ElectronicCats/Minino/docs/esp-sdr-integration.md

# Native SDR Integration in Minino

> **Usage guide:** [`sdr-guia.md`](./sdr-guia.md) (getting started, the
> three ways to use it).
> **Test report:** [`sdr-resultados.md`](./sdr-resultados.md)
> (both boards, both applications, spectrum profiles).
> **Wire protocol, byte by byte:** [`sdr-protocolo.md`](./sdr-protocolo.md)
> (both packet formats, raw bytes, and where each field appears).

Reference document for the integration between Minino (ESP-IDF) and the
software-defined radio firmware. Dual boot has been retired:
the SDR runs **in-process** inside Minino OS, without touching `ota_1`.

- **Date:** 2026-10-19 (updated 2026-10-21)
- **Boards used:** ESP32-C6 rev v0.1 (`f0:f5:bd:27:6b:00`) and rev v0.2
  (`48:f6:ee:c2:a2:14`), both 8 MB
- **Toolchain:** ESP-IDF v5.5.1, target `esp32c6`
- **Companion document:** [`changes-refactor-system-overhaul.md`](./changes-refactor-system-overhaul.md)
  (covers the entire branch, and section 23 covers the ESPARGOS web connection)

---

## 1. Executive Summary

`Applications > SDR` opens a native Minino application ("SDR",
`MENU_ESP_SDR`, option `CONFIG_SDR_ENABLE`): I/Q burst capture using the
C6 dump engine, saved to the microSD card. The user interface is Minino's
own UI, without a boot handover, without a second image, and without losing
the screen.

Dual-booting into a second application on `ota_1` was previously
implemented (see git history) and worked with the native ESP-IDF image of
[ESPARGOS esp-sdr](https://github.com/ESPARGOS/esp-sdr), but it was
dropped in favor of the native port: a single image, a single console, and
no risk of being left without an OS if the `ota_1` payload becomes corrupted.

> **The SDR requires its own build variant** (see section 5.1). The
> capture bank consumes an entire SRAM block and the linker script
> limits the image to 256 KB; with the Zigbee and Thread stacks included,
> the image exceeds that limit by 45 KB. Therefore, there are two images:
> the standard board image with all stacks enabled and SDR disabled, and
> the SDR image with those two stacks excluded and SDR enabled. Neither
> image touches `ota_1`.

---

## 2. Architecture

```
Minino OS (factory / ota_0)
└── main/modules/esp_sdr/           <- native app, same image as the rest of Minino
    ├── c6_sdr_rx.c                 <- RX dump engine (direct register access, 80 MS/s)
    ├── iq_pack.c                   <- 8/12/16-bit I/Q packing
    ├── osmosdr_serial.c            <- esdr protocol parser (esdr_proto.h)
    ├── sdr_screen.c                <- OLED status view
    └── esp_sdr_module.c            <- menu app: tuning, capture, save to SD
```

- The radio is managed by `radio_lease`: RX holds a promiscuous claim
  (`radio_lease_prom_hold(RADIO_PROM_SDR_RX)`), ensuring coexistence with
  the rest of the BLE/Wi-Fi apps.
- `c6_sdr_rx_init()` starts the Wi-Fi driver if it is not already running,
  because the dump engine requires the PHY clocks and calibration.
- Captures a burst of up to 16,380 words (32-bit packed I/Q).
- Bursts are saved as `sdrcap00.iq`, `sdrcap01.iq`, ... on the microSD card
  (`/sdcard`); without an SD card, the app displays the burst and skips saving.
  The filename is generated by `files_ops_incremental_name_buf()` using the
  `"%s%02d"` format (`files_ops.c:320`): two digits minimum, up to 9,999 files.

## 3. Capture Structure

`SDR_CAPTURE_BANK_BASE` (0x40840000, `main/modules/esp_sdr/esp_sdr_memory.h`)
is the SRAM bank written directly by hardware while RF is running; the CPU
does not touch it during capture. The application performs the following steps:

1. TUNE: configures the Wi-Fi channel (2407+5n) to obtain calibration, then
   enables the RX chain via `pbus_workmode()` / `ram_pbus_xpd_rx_on()`.
2. CAPTURE: triggers `DUMP_CTRL` with the sample count and configuration
   registers; hardware dumps 80 MS/s directly into SRAM.
3. VERIFY: checks a canary at the start of the buffer and enforces a 25 ms
   timeout on `DUMP_CTRL`.
4. SAVE: `iq_pack_raw` is bypassed; raw words are copied directly to the file
   without conversion. The word layout matches the hardware dump engine:

   ```
    31        28 27        20 19        10 9         0
   +------------+------------+------------+------------+
   |   (used)   |    gain    |     Q      |     I      |
   |            |   index    | (10 bits)  | (10 bits)  |
   +------------+------------+------------+------------+
   ```

   **I is in bits 9-0 and Q is in bits 19-10**, both signed
   (-512..+511). Note: the `esp-sdr-zephyr` project has them reversed
   (its `esp_sdr_rx_i()` extracts I from bits 19-10); the authoritative
   reference is the diagram in `docs/how-it-works.md` from the ESPARGOS
   repository, which uses the same hardware registers.

## 4. Usage

### On the Device (`Applications > SDR`)

The native application provides **4 operating modes** cycled by pressing the **`BOOT`** button or holding **`RIGHT`**:

1. **`[IDL]` / `[RX]` (RX I/Q Burst Capture)**: Captures bursts of 8,192 I/Q samples at 80 MS/s, calculates physical RSSI in `dBm`, and saves `/sdcard/sdrcapXX.iq` files to the microSD card.
2. **`[TX:PKT]` (TX 802.11 Raw)**: Sends bursts of 5 802.11 Probe Request frames (`MININO-SDR-TX`) on the selected channel (`2412-2484 MHz`).
3. **`[TX:CW]` (TX CW Tone)**: Emits a continuous RF carrier using the PHY synthesizer (`c6_sdr_tx_carrier_start`) with an automatic 30-second safety timeout.
4. **`[HOST]` (ESPARGOS WebSDR Host)**: Connects directly to the web application at <https://espargos.net/espsdr/app/> over USB Serial/JTAG.

Controls:
- `UP` / `DOWN` buttons: Tune from `2412` to `2484 MHz` (Channels 1 to 14).
- `RIGHT` (short press): Captures and saves a burst in `[RX]`, transmits packets in `[TX:PKT]`, or toggles the carrier in `[TX:CW]`.
- `BOOT` or `Hold RIGHT`: Switches to the next operating mode.
- `LEFT`: Exits to the main menu, returning the radio to Minino.

> **Automatic Web Host activation:** If you are inside `Applications > SDR` in any mode and open <https://espargos.net/espsdr/app/> and click **Connect**, the console detects the `SYNC` command and automatically switches the app to `[HOST]` mode without typing commands or switching modes manually. Additionally, setting `USB_SERIAL_JTAG.chip_rst.usb_uart_chip_rst_dis = 1` prevents browser DTR/RTS signals from resetting the board.

### Via Console

- `sdr_capture`: opens the native app (identical to the menu entry).
- `sdr_host`: hands the USB port over to the ESP-SDR protocol spoken by
  the browser at <https://espargos.net/espsdr/app/>. See section 8.

## 5. The Capture Bank: Why the Firmware Must Fit Below It

The C6 dump engine does not write to an arbitrary buffer: it takes over SRAM
block 2 (0x40840000..0x40860000, 128 KiB) for the duration of the capture and
writes into its first 64 KiB. Anything living in that region while the engine
runs:

- is overwritten by hardware (the samples), and
- causes any CPU access to hang, because the block no longer belongs to
  the CPU.

Standard Minino firmware placed its `.bss` and heap there: upon entering the
SDR app, the engine overwrote ~121 KiB of live variables. The symptom was a
*Guru Meditation* (`Instruction access fault`, PC at `0x944f00e0`, which is
not code) immediately upon tuning the channel, because the heap and `.bss`
were already corrupted.

Upstream solves this by reserving the block in the linker
(`esp-sdr-zephyr/lib/esp_sdr/esp_sdr_bank_c6.ld`). Here, the full Minino
image does not fit as-is: the normal `.bss` takes 172 KiB and block 2 is
only 128 KiB. The unified firmware is the result of trimming just enough
to fit below the bank:

| Component | Purpose |
|---|---|
| `firmware/main/esp_sdr_bank.ld` | Redefines the `sram_seg` region with length 0x40000: nothing in the image can cross 0x40840000, and if it does not fit, linking fails with *"SDR: the DRAM image overlaps the capture bank"* |
| `firmware/main/modules/esp_sdr/esp_sdr_memory.c` | Reserves the block from the heap via `SOC_RESERVE_MEMORY_REGION()` (the same mechanism used by ESP-IDF), preventing `heap_caps` from allocating it |
| `firmware/cmake/minino_kconfig.cmake` | Helper to read Kconfig options directly from `sdkconfig` (see below) |

### 5.1 The SDR Build Variant

The capture bank is not just a slice of RAM: it is an entire hardware block
removed from the heap, and the linker script (`esp_sdr_bank.ld`) caps the
`sram_seg` region so the image fits below `0x40840000`. With the full
feature set enabled, it does not fit:

| Metric | Value |
|---|---|
| Budget (the two SRAM blocks below the capture bank) | 256 KB |
| Image with Bluetooth, Zigbee, and Thread included | 301 KB |
| Image with Zigbee and Thread stacks excluded | 249 KB |

The project's own Kconfig already noted this (`MININO_ZIGBEE_STACK`):

> Disabling this frees ~30+ KB of DRAM **and is required for the SDR
> build variant**.

Therefore, there are two profiles:

| Variant | Profile | Configuration | Size | Flash Margin |
|---|---|---|---|---|
| Boards | `profiles/<board>/profile` | Everything enabled, `CONFIG_SDR_ENABLE` off | 3377 KiB | 8.7% |
| SDR | `profiles/sdr/profile` | Zigbee and Thread off, `CONFIG_SDR_ENABLE` on | 2496 KiB | 32.5% |

```bash
make builds        # standard board profiles
make build-sdr     # SDR variant
```

The SDR variant enables the `Applications > SDR` menu entry, the
`sdr_capture` command, and `sdr_host`. In the standard board images, the SDR
code is still compiled (the `main` glob compiles everything), but **there is
no capture bank reserved behind it**: that is why `CONFIG_SDR_ENABLE` is
disabled in `sdkconfig.defaults` and the menu hides the entry.

### Trims That Made It Fit

The image went from 374 KB down to 255 KB of IRAM+data+bss (the budget is
256 KB, corresponding to the two SRAM blocks below the bank):

| Optimization | KB Saved |
|---|---|
| Moved Wi-Fi and PHY hot code out of IRAM (same change made by the esp-sdr project) | 45.6 |
| Moved OpenDroneID spoofers to the heap, allocated per configured drone | 37.7 |
| Excluded `librftest.a` from linking (cert-test is unnecessary without TX) | 44.7 |
| Reduced event bus subscriber table (16 -> 4 per topic, 80 -> 60 topics) | 14.6 |
| Trimmed surveillance log, file tree, and SSID list buffers | 4.5 |
| Reduced surveillance detector tables (200 -> 80 devices, 50 -> 20 traces) and signature tables | 7.0 |
| Moved OpenDroneID BLE drone state to the heap | 2.3 |
| Moved OLED font to flash (was only partially `const`) | 1.0 |

### Reserving the Entire Block (128 KB), Not Just the 64 KB Written

The dump engine writes **exactly 16,384 words (65,536 bytes)** at
0x40840000: verified with a probe that fills the block with a pattern and
counts how many words change (16,384 words change, the last being index
16,383). Nothing touches the remaining half of the 128 KB block: neither the
Wi-Fi driver nor Bluetooth (verified with the same probe).

**Even so, the entire 128 KB block must be excluded from the heap.** The
ownership bit in `SRAM_OWNER_REG` operates **per block**, not per page: while
capture is running, the CPU cannot read **anything** from the 128 KB block,
not even the upper half that the engine leaves untouched. If the heap is
allowed to use that upper half (when reserving only 64 KB), the Wi-Fi driver
places buffers there that become **inaccessible during capture**: the driver
stalls waiting on its own buffers, the task watchdog triggers, and the board
resets with:

```
rst:0x8 (TG1_WDT_HPSYS),boot:0x7c (SPI_FAST_FLASH_BOOT)
```

This is a subtle failure: a 16,380-sample capture succeeds (the engine writes
65,520 bytes), but any shorter capture triggers it, causing the watchdog to
reset the board.

> **Correction to earlier notes.** An earlier version of this section stated
> that reserving all 128 KB broke Bluetooth (leaving the largest contiguous
> heap block at 113 KB while the C6 controller requests 121 KB). Measured on
> hardware with the full 128 KB reservation, **BLE scanning works**: 35
> trackers detected, with no `HCI_ERR_MEM_CAPACITY_EXCEEDED`. The contiguous
> block required by Bluetooth is allocated below 0x40840000, not in the upper
> half of the dump engine block.

### The Bank on Hardware

With the 128 KB reservation:

```
heap_init: At 40833480 len 0000CB80 (50 KiB): RAM    <- below the bank
heap_init: At 40860000 len 0001C610 (113 KiB): RAM   <- above the bank
heap_init: At 4087C610 len 00002F54 (11 KiB): RAM
```

The range 0x40840000..0x40860000 does not appear in the heap list: it belongs
to the dump engine.

### Note on `if(CONFIG_*)` in CMake

ESP-IDF evaluates each component's `CMakeLists.txt` **twice**: once when
expanding the component tree (before the Kconfig pass, when no `CONFIG_*`
variables exist yet) and again during compilation. A bare `if(CONFIG_BT_ENABLED)`
takes the false branch on the first pass, registering the component with no
sources or requirements (causing linking to fail with *"bt_gattc.h includes
esp_bt.h ... not in the requirements list of bt_gattc"*).

`firmware/cmake/minino_kconfig.cmake` solves this by reading the option
directly from the `sdkconfig` file (which is available on both passes) and
exposing:

```cmake
include("${CMAKE_CURRENT_LIST_DIR}/../../cmake/minino_kconfig.cmake")
minino_kconfig_enabled(BT_ENABLED _minino_opt_on)
if(_minino_opt_on)
    idf_component_register(SRCS ...)
else()
    idf_component_register()
endif()
```

New project options (`MININO_ZIGBEE_STACK`, `MININO_OPENTHREAD_STACK`) are
intentionally prefixed with `MININO_`: a Kconfig symbol cannot be defined in
two places, and `OPENTHREAD_ENABLED` is already defined by the upstream
component.

---

## 6. TX Support: Hardware Limitations on the ESP32-C6

The C6 **cannot transmit arbitrary I/Q**: its dump engine is a receiver (it
writes demodulated radio samples into SRAM rather than playing them back) and
it lacks a TX DAC (which the S3 has). The only native signal the chip can
emit via ROM/PHY test routines is the cert-test **tone mode**,
`esp_phy_wifi_tx_tone()`, located in `librftest.a`, or synthesized PHY
carriers / raw 802.11 frames.

Linking `librftest.a` tone mode was tested in two ways (linking the entire
archive, or linking only `rf_test.o` + `esp_phy_api.o` with a custom wrapper),
but it **does not radiate** without full cert-test initialization: measurements
with a HackRF showed an identical spectrum with the tone on and off. The
cert-test tone requires the full PHY *cert test* state prepared by
`rftest_init()` in `wifi.o`; pulling in that object drags in `mac_common.o`
with 45 KiB of `.bss` (the rxtest I/Q buffers), which does not fit below the
capture bank.

In upstream esp-sdr, the C6 also lacks I/Q TX: its only transmission backend
is the S3 DAC.

Consequently, **I/Q streaming SDR is receive-only**; the legacy `rf_tx`
console command and the `librftest.a` cert-test archive link were removed. The
TX mode of the osmoSDR protocol is rejected with `-ENOTSUP` instead of failing
silently.

## 7. Verification

```bash
make tests                        # includes main/modules/esp_sdr/test
# on hardware:
#   Applications > SDR -> burst, check /sdcard/sdrcap00.iq
```

Measured on hardware (ESP32-C6 rev v0.2, unified SDR firmware):

```
I (6918) c6_sdr_rx: Tuned to 2412 MHz (CH 1)
I (7102) esp_sdr_module: burst 1: 16380 words in 217 us (not saved: no SD)
```

16,380 words (65 KiB) in 217 us corresponds to 76 MS/s, consistent with the
80 MS/s rate of the dump engine. Prior to reserving the bank, the exact same
sequence ended in a Guru Meditation fault.

Hardware test note: the microSD card on that specific test unit did not
respond ("R1 response: command not supported"), so the burst was not written
to disk, while the capture itself succeeded. SD mounting previously returned
`ESP_ERR_NO_MEM` when no card responded, which was misleading; the underlying
cause was the card failing to reply.

---

## 8. Host Mode: Communicating with the ESPARGOS Web Client

> **Added 2026-10-21.**

The web client at <https://espargos.net/espsdr/app/> (ESP-WebSDR) is a
spectrum and waterfall analyzer that connects to the ESP over USB and requests
I/Q bursts. It speaks the **line-oriented protocol** of the ESP-SDR *burst*
firmware, which is distinct from the binary `ESRL` protocol implemented in
`osmosdr_serial.c` (used by the desktop SoapySDR driver).

### 8.1 The Protocol

```
SYNC <nonce>   -> SYNC <nonce>
INFO           -> C6SDR 6 burst 16380
CAPS           -> CAPS VERSION RXLIMITS HWAGC IQ8 SERIALLEASE TUNEEXT RX40 RX16
VERSION?       -> VERSION {"revision":"unknown","build_date":"...","build_timestamp":"...","profile":"esp32c6"}
TRANSPORT?     -> TRANSPORT USB 0
RELEASE        -> OK
FREQ <MHz>     -> OK
LIMITS?        -> LIMITS {"gain":[0,0,1],"bandwidth":null,"rates":[80000000,40000000,16000000],"bits":[8,10]}
RANGE?         -> RANGE 2412 2472 1
CAP16 <n> <r>  -> DATA <n> <crc32hex> <us>  +  2*n bytes
CAP20 <n> <r>  -> DATA <n> <crc32hex> <us>  +  ceil(20*n/8) bytes
```

The browser applies strict regular expressions to each response, so the format
is fixed:

```js
/^(ESP32|C2|C3|C5|C6|C61|H2|S2|S3|S31)SDR 6 burst (\d+)$/   // INFO
/^TRANSPORT (UART|USB) (\d+)$/                              // TRANSPORT?
/^DATA (\d+) ([0-9a-fA-F]{1,8}) (\d+)$/                      // capture header
```

The CRC32 is standard zlib CRC32 calculated over the packed payload.

### 8.2 Sample Formats

| Format | Layout | Bytes per Sample |
|---|---|---|
| `CAP16` | I followed by Q, taking the upper 8 bits of each 10-bit field | 2 |
| `CAP20` | 20 bits per pair, least significant bit first: **I in bits 0-9 and Q in bits 10-19** | 2.5 |

The 20-bit group is extracted directly from the raw hardware word, which
already places I in bits 9-0 and Q in bits 19-10.

### 8.3 Port Handover

The web client and the Minino console share the USB Serial/JTAG port, and the
console echoes characters as it reads them (linenoise), meaning the REPL
cannot remain active while the browser expects clean protocol responses.

The solution is for **the console itself to hand over the port**:

```
minino> sdr_host
Serving the ESP-SDR protocol on the USB port.
Open https://espargos.net/espsdr/app/ and connect to this board.
The console comes back when the viewer sends RELEASE, or type MININO.
```

The command runs inside the console task, so while the session is active, the
console is blocked between reads: the port has a single reader and bytes are
never split between two consumers.

During the session:

- the **master log level** is lowered to `ESP_LOG_NONE` (a log line emitted
  in the middle of a binary capture corrupts the frame);
- the radio driver acquires a Wi-Fi *lease* and only releases it when the last
  holder drops it; after 5 s of inactivity the radio returns to the pool, and
  after one minute of inactivity the session terminates.

### 8.4 Requirements for Capturing Real Signal

The C6 RX chain requires more than simply turning on the receiver. The
ESPARGOS firmware configures it as follows (`receiver.c:292-298`):

```c
    ESP_ERROR_CHECK(esp_wifi_set_ps(WIFI_PS_NONE));
    ESP_ERROR_CHECK(esp_wifi_set_promiscuous(true));
```

**Without disabling power save and enabling promiscuous mode, the capture
returns a constant DC value**: I = -63 and Q = -62, identical across all 13
channels. The dump engine runs (the canary is overwritten and guard words
remain intact), but the ADC input is held constant because in normal STA mode
the radio manages its own lifecycle: sleeping, scanning, and associating.

With both settings enabled, the capture contains real RF signal (measured on
an ESP32-C6 rev v0.2):

| Channel | Without Power Save / Promiscuous | With Both Enabled |
|---|---|---|
| 2412 MHz | I = -63, variance 0 | I = 130, variance 9,090 |
| 2472 MHz | I = -63, variance 0 | I = 25, variance 13,901 |

And the spectrum goes from a flat line to 87 dB of dynamic range.

In Minino, promiscuous mode is requested **through the lease**
(`radio_lease_prom_hold(RADIO_PROM_SDR_RX)`), ensuring other apps sharing the
radio do not disable it underneath the SDR.

The ESPARGOS firmware also programs the PHY channel directly via
`chip_v7_set_chan()`. **In Minino, calling that directly hangs the board**:
the Wi-Fi driver maintains its own PHY state, reinitializes it upon detecting
the change, and stalls. With the Wi-Fi driver active, channel selection is
performed through the driver API as usual.

### 8.5 Chunked Binary Payloads

The USB Serial/JTAG driver writes outgoing data into a 256-byte ring buffer
via `xRingbufferSend()`, and that call **rejects any block larger than the
ring buffer**: it waits for space that can never exist and returns 0 without
writing anything. A capture of 16,380 samples is 40,950 bytes, so the payload
must be sent in chunks matching the hardware FIFO size:

```c
#define ESDR_TX_CHUNK 64
```

### 8.6 Spectrum Mode: On-Chip FFT

The ESPARGOS viewer supports two modes: burst mode (described above) and
**on-chip spectrum mode** ("On-Chip Spectrum"), which refreshes at dozens of
frames per second. In this mode, the board computes the FFT locally and sends
an array of power codes instead of raw I/Q samples.

Minino implements this in `main/modules/esp_sdr/esdr_spectrum.c`, ported from
the ESPARGOS firmware (`main/common/spectrum.c` and related files).

| Command | Response |
|---|---|
| `SPECINFO?` | `SPECINFO {"continuous":false,"transports":["USB"],"profiles":[[80000000,0,256,1,1,0],...]}` |
| `SPEC <ms> <step> <units> <det> <rate> <bins>` | `SPEC <bins> <rate_hz> <bins> <mhz>` followed by binary frames |
| `DC?` / `DC 0` / `DC 1` | `DC <mode>` / `OK` |
| `BAUD?` / `BAUD ...` | `ERR baud_transport` (this session runs over USB) |

The profiles cover all three C6 sample rates (80, 40, and 16 MS/s) with 256,
512, 1024, and 2048 bins, matching what the viewer requests (its `MAX_FFT` is
also 2048).

**Frame layout.** Each frame consists of a 28-byte header, the bins in natural
frequency order, and a 4-byte CRC32:

| Offset | Bytes | Content |
|---|---|---|
| 0 | 4 | ASCII `SPC1` |
| 4 | 4 | Frame sequence number |
| 8 | 8 | Index of the first sample |
| 16 | 4 | Sample span covered by the frame |
| 20 | 2 | Number of FFTs accumulated |
| 22 | 1 | Flags (bit 0: max-hold detector, bit 3: gaps between captures) |
| 23 | 1 | Gain metadata |
| 24 | 2 | Cumulative dropped frames |
| 26 | 1 | log2(bins) |
| 27 | 1 | Code multiplier in dB (2) |
| 28 | N | Power codes, in natural FFT order |
| 28+N | 4 | CRC32 over the header and bins |

Each power code represents `20*log10(power)` in the Q15 domain, clamped to
0..255.

**The FFT** is a decimation-in-time radix-2 FFT with bit-reversed input
permutation, where **each butterfly divides by two**: without stage scaling, a
strong tone would saturate Q15 in the first stage. The host unit test verifies
it against a direct DFT, because a spectrum with misordered bins can still
look plausible on screen while misrepresenting the signal.

**The watchdog.** The spectrum loop cannot monopolize the CPU: the idle task
feeds the task watchdog, so the loop yields every 20 ms.

### 8.7 Source Files

| File | Description |
|---|---|
| `main/modules/esp_sdr/esdr_burst_proto.c/.h` | Protocol implementation: pure C, no ESP-IDF dependencies, with 24 host unit tests |
| `main/modules/esp_sdr/esdr_spectrum.c/.h` | On-chip spectrum: FFT, frame builder, and CRC |
| `main/modules/esp_sdr/esdr_transport.h` | Shared transport abstraction used by both modules |
| `main/modules/esp_sdr/esdr_host.c/.h` | USB host session handler |
| `main/modules/esp_sdr/test/test_esdr_burst_proto.c` | Wire format unit tests |

Full details are provided in section 23 of
[`changes-refactor-system-overhaul.md`](./changes-refactor-system-overhaul.md).

### 8.8 Negotiated Capabilities and Hardware Limits

| Capability | Status in Minino |
|---|---|
| RX Gain (`GAIN`) | Supported (`GAIN 0..60 dB`, 3 dB step, configured in the receiver LNA/AGC registers) |
| Sample Rate Decimation (`RATES`) | Supported in real time (`80 MS/s`, `40 MS/s` via 2x decimation, and `16 MS/s` via 5x decimation) |
| On-Chip Spectrum (`SPEC`) | Supported via on-board radix-2 Q15 FFT (`256`, `512`, `1024`, and `2048` bins) and `SPC1` frames with CRC32 |
| Analog Bandwidth | `ALPF` is not advertised (fixed per PHY channel) |
| GPIO | `GPIO` is not advertised |
| 5 GHz | The ESP32-C6 operates exclusively in the 2.4 GHz band (`2412-2484 MHz`) |

The **"Flash Firmware..."** button in the browser flashes upstream ESPARGOS
firmware over Minino and should be ignored.

---

## 9. Over-the-Air Testing: Two Boards

> **Added 2026-10-21.**

One board transmits while the second receives using the SDR. The receiving
board enters host mode (speaking the ESPARGOS browser protocol) while the
transmitting board radiates. This provided the missing validation: previously,
the SDR had only been tested against ambient background noise, never against a
controlled signal transmitted by a second board.

### 9.1 Test Setup

| Board | Role | Configuration |
|---|---|---|
| A | Transmitter | `launch spam_all` (BLE), `launch ssid_spam` (Wi-Fi beacons), `launch flock_sim` (Flock simulator) |
| B | SDR Receiver | `sdr_host` on the console, driven via the browser protocol |

Both boards run the SDR build variant (`make build-sdr`), which reserves the
capture bank.

### 9.2 Two Bugs Uncovered During Testing

**The SSID spammer was not transmitting.** `launch ssid_spam` opened the app,
but the app **transmitted nothing**: the SSID list was only loaded when the
user selected an item from the UI menu, and when launched from the console no
item was selected. The spam task saw an empty list (`ssid_spam.c:196`) and
exited without transmitting: the app appeared to run while the airwaves
remained silent.

Now the stored list is loaded automatically when the app opens
(`ssid_spam_load_stored_list()`), so `Start` works both from the menu and from
the console:

```
minino> spam_save --name=minino MININO_SDR_1,MININO_SDR_2,MININO_SDR_3
minino> launch ssid_spam
minino> press down        # menu: "List SSID" / "Start"
minino> press right       # Start
```

> `press` is the existing test hook (`cmd_control.c`) that injects a button
> event.

**Re-entering the app crashed the board.** `esp_netif_create_default_wifi_ap()`
triggers an `assert()` if the default AP netif already exists, so starting the
spammer twice in a row (or re-entering the app) crashed the board with a
*"duplicate key"* error. The netif is now created only if it does not already
exist (`esp_netif_get_handle_from_ifkey("WIFI_AP_DEF")`).

### 9.3 Measurements

With Board A transmitting and Board B receiving:

| Test | Result |
|---|---|
| `tools/test_esdr_web.py` (browser protocol, byte for byte) | **56 of 56** |
| `tools/test_esdr_spec.py` (spectrum mode) | **28 of 28** |
| `make tests` (all 20 host test suites) | **0 failures** |
| Native app (`sdr_capture` + `press right`) | `burst 2: 16380 words in 218 us` |
| Tuning (`press up`) | `Tuned to 2417 MHz (CH 2)` |
| Exit (`press left`) | `The Wi-Fi driver was started for the capture and is free again` |
| Single burst spectrum | Peak -5.6 dBFS, noise floor -91.8 dBFS, **86 dB dynamic range** |
| Signal in bursts | RMS 0.227, peak 0.492 (not flat noise) |

Both test suites passed **with the second board actively radiating**, not in
quiet conditions.

### 9.4 Confirming Reception on the Second Board

Board B's standard Wi-Fi receiver clearly detects Board A's beacons. With
Board A spamming and Board B running `wifi_scan`:

```
[-46] MININO_SDR_3       <- Board A
[-46] MININO_SDR_1       <- Board A
[-53] INFINITUM2843      <- strongest ambient AP
[-81] Totalplay-77A5
[-88] Totalplay-77A5_EXT
...
```

At -46 dBm, Board A is **stronger than any ambient AP**. Radiation from Board A
unquestionably reaches Board B.

### 9.5 What the SDR Sees

The difference between the spectrum with transmission active versus inactive
appears directly in the transmitter's band.

With the Wi-Fi beacon spammer running (LO at 2412 MHz), the transmitter's DSSS
lobe appears between +9 and +16 MHz (i.e., **2421..2428 MHz**), measuring +0.2
to +1.1 dB above the non-transmitting baseline. When tuned to 2427 MHz
(channel 4), the same lobe centers on the LO, confirming the transmitter is on
that channel.

> The spammer configures its AP on channel 1, but beacons are transmitted on
> whatever channel the radio is currently using: `esp_wifi_80211_tx()` uses
> the active operating channel rather than the AP configuration channel.

With the BLE spammer running, the difference concentrates in the advertising
channels: **+13.5..+14.3 MHz** from the LO (BLE channel 38, 2426 MHz) and
around -10/-11 MHz (BLE channel 37, 2402 MHz).

### 9.6 Measurement Limits in an Unshielded Environment

The average difference between TX on and TX off is +0.2 to +1.1 dB, while the
**negative control** (comparing two windows in the same state) shows +1.0 to
+1.4 dB of variation in the same bands: in an open environment, ambient RF
fluctuation is on the same order of magnitude as the average effect.

The reason is physical rather than a flaw in the SDR: the 2.4 GHz band is
congested (nearest ambient AP at -48 dBm), the receiver's hardware AGC
normalizes total gain, and Minino's transmitters have a low duty cycle (the
beacon spammer sends one frame every 100 ms). Individual narrowband peaks are
clearly visible when a burst catches a packet in flight (a burst capturing a
BLE advertising carrier measured +10 dB above the floor), but long-term
averages blend into ambient traffic.

Unambiguous average power attribution requires an RF-quiet environment (or a
shielded enclosure) rather than longer averaging.

### 9.7 Test Tools

```bash
python3 tools/test_esdr_radio.py <rx_port> <tx_port> [options]
```

Measures the spectrum difference (or narrowband power across multiple
frequencies) with transmission toggled on and off across alternating windows,
comparing each window against its immediate neighbors to cancel out slow
ambient drift. This reproduces the measurements in section 9.5.

To test both SDR applications across both boards:

```bash
python3 tools/test_esdr_app.py  <port>     # native app on a single board
python3 tools/test_esdr_pair.py app+spec <port_1> <port_2>
python3 tools/test_esdr_pair.py spec+spec <port_1> <port_2>
```

Section 5 of [`sdr-guia.md`](./sdr-guia.md) documents the results of that test
matrix.

### 9.8 Board-to-Board Level Differences Due to Placement

When both boards measure the spectrum simultaneously, their profiles share the
same shape but show up to a **14.7 dB level difference**. Running `wifi_scan`
on both boards at the same time explains why: the exact same ambient APs
register +13 dB stronger on one board than on the other due to multipath and
antenna position. Two SDR boards are only directly comparable in absolute
level if placed in the exact same position (or inside a shared test chamber).
