ElectronicCats/Minino/firmware/resources/FACE.png

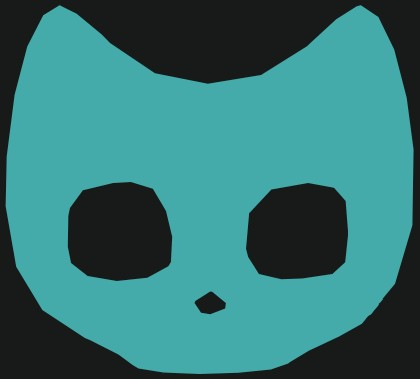
firmware/resources/FACE.png
