ElectronicCats/Minino/firmware/components/openthread/openthread/tools/harness-automation/doc/index.rst

.. Thread Harness Automation documentation master file, created by
   sphinx-quickstart on Wed Jun 29 15:18:24 2016.
   You can adapt this file completely to your liking, but it should at least
   contain the root `toctree` directive.

Welcome to Thread Harness Automation's documentation!
=====================================================

Contents:

.. toctree::
   :maxdepth: 2

   quickstart
   api/modules

Indices and tables
==================

* :ref:`genindex`
* :ref:`modindex`
* :ref:`search`
