ElectronicCats/Minino/case/PART_A-MININO.stl

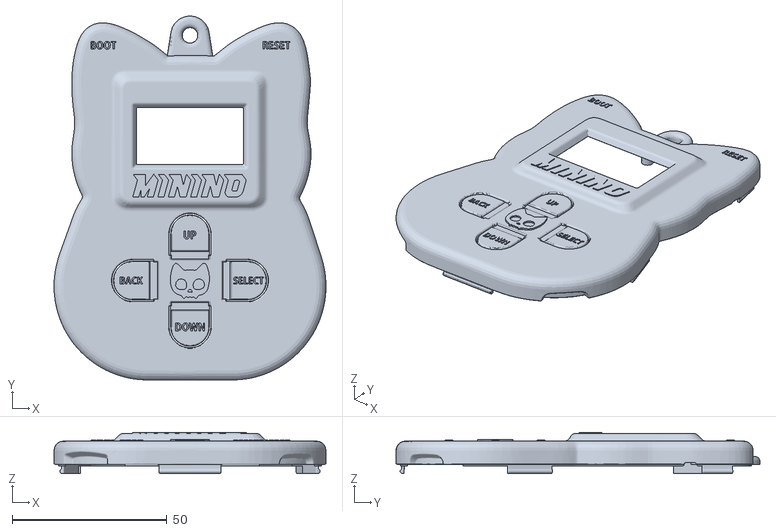
[picture p5: CAD file, 2025-04-28]
case/PART_A-MININO.stl
88.0 x 117.8 x 13.3
