ElectronicCats/Minino/hardware/3D/IPEX U.FL-R-SMT-IPEX U.step

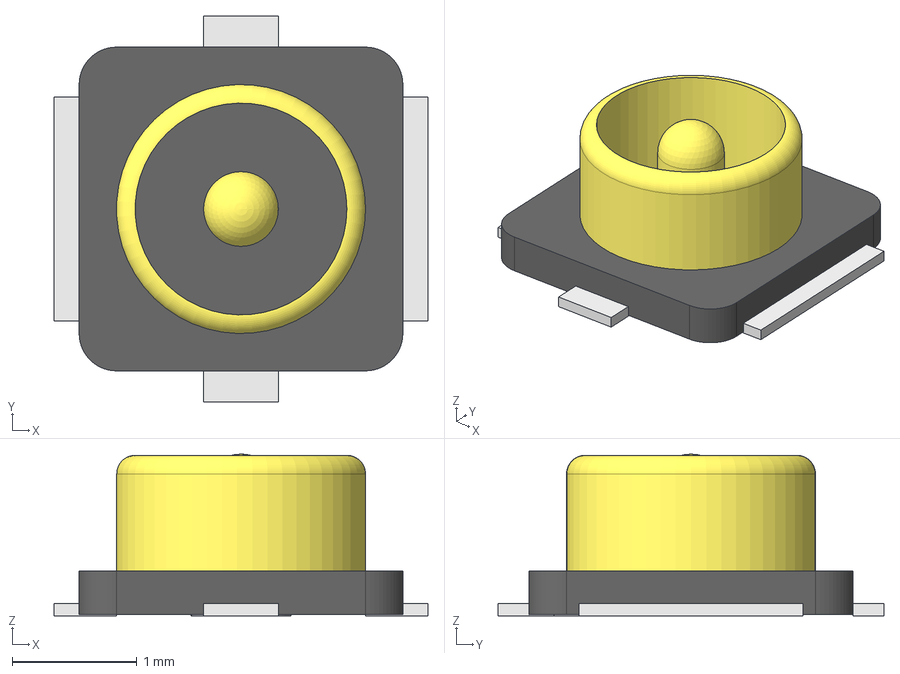
[picture p6: CAD file, 2024-07-29]
hardware/3D/IPEX U.FL-R-SMT-IPEX U.step
3.00 x 3.10 x 1.30 mm
