ElectronicCats/Minino/case/PART_B-MININO.stl

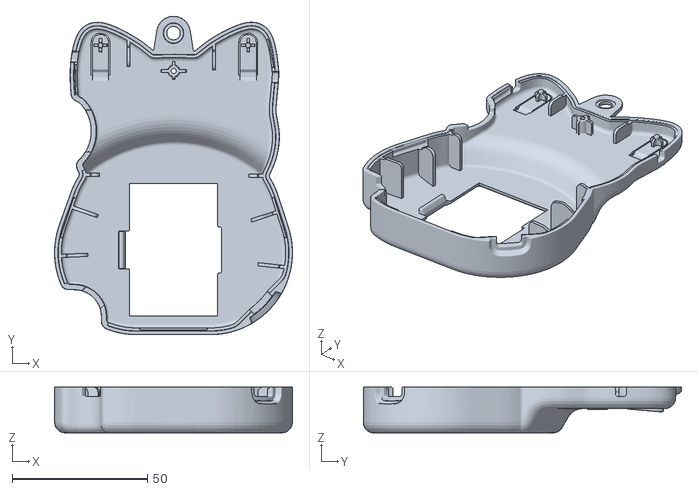
[picture p7: CAD file, 2025-04-28]
case/PART_B-MININO.stl
88.0 x 117.8 x 17.0
