ElectronicCats/Minino/hardware/3D/SOT23-6.STEP

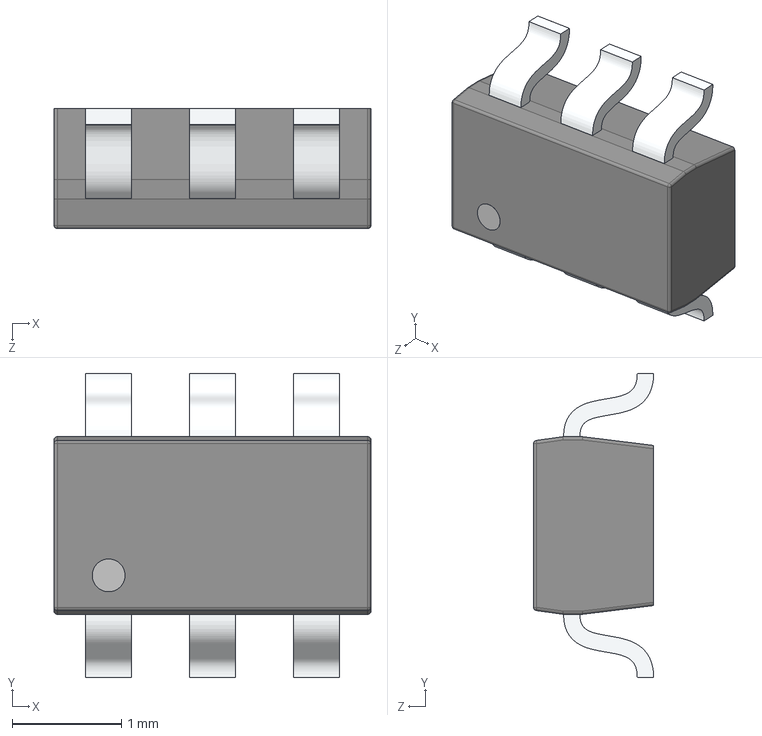
[picture p8: CAD file, 2024-07-29]
hardware/3D/SOT23-6.STEP
2.90 x 2.78 x 1.10 mm
