ElectronicCats/Minino/case/BAT_LID-MININO.stl

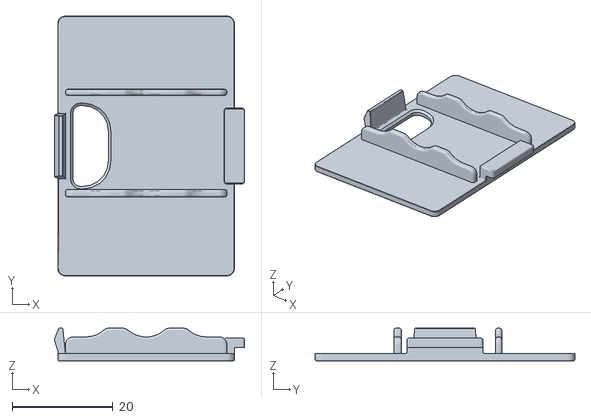
[picture p9: CAD file, 2025-04-28]
case/BAT_LID-MININO.stl
37.7 x 51.5 x 6.50
