ElectronicCats/Minino/hardware/3D/SMT-0440-T-R.step

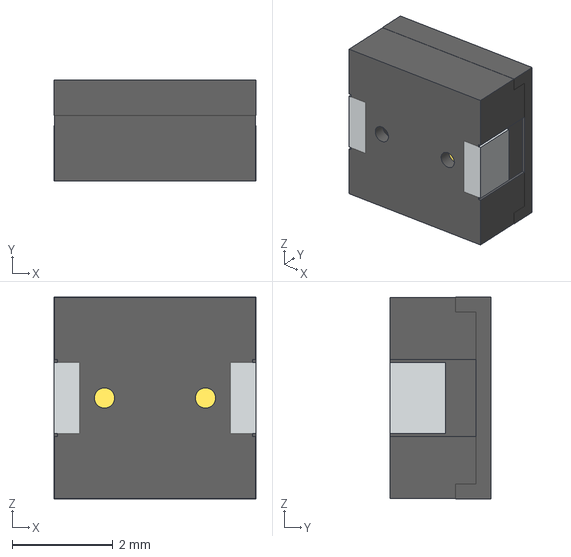
[picture p10: CAD file, 2024-07-29]
hardware/3D/SMT-0440-T-R.step
4.00 x 2.00 x 4.00 mm
