ElectronicCats/Minino/hardware/3D/L70.STEP

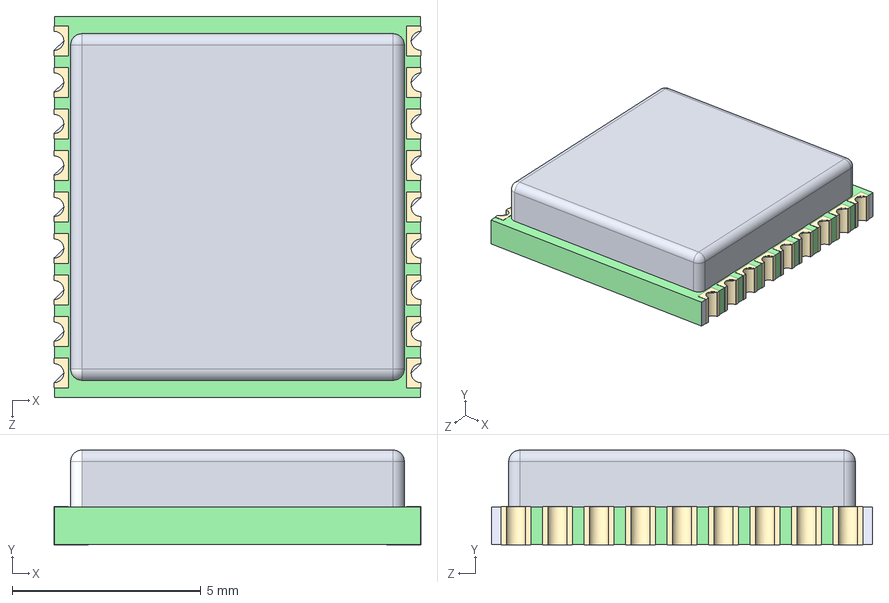
[picture p11: CAD file, 2024-07-29]
hardware/3D/L70.STEP
9.72 x 2.51 x 10.1 mm
