ElectronicCats/Minino/hardware/3D/ST-TF-003A.step

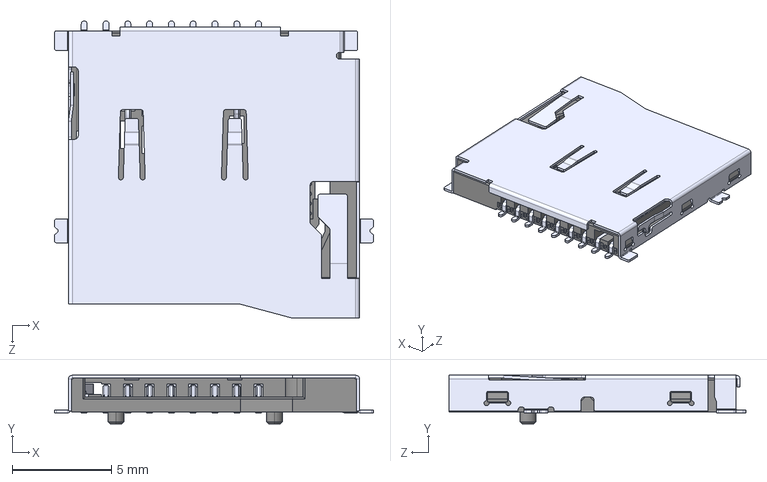
[picture p12: CAD file, 2024-06-18]
hardware/3D/ST-TF-003A.step
16.1 x 2.45 x 15.0 mm
