ElectronicCats/Minino/hardware/3D/3x AAA battery holder.stp

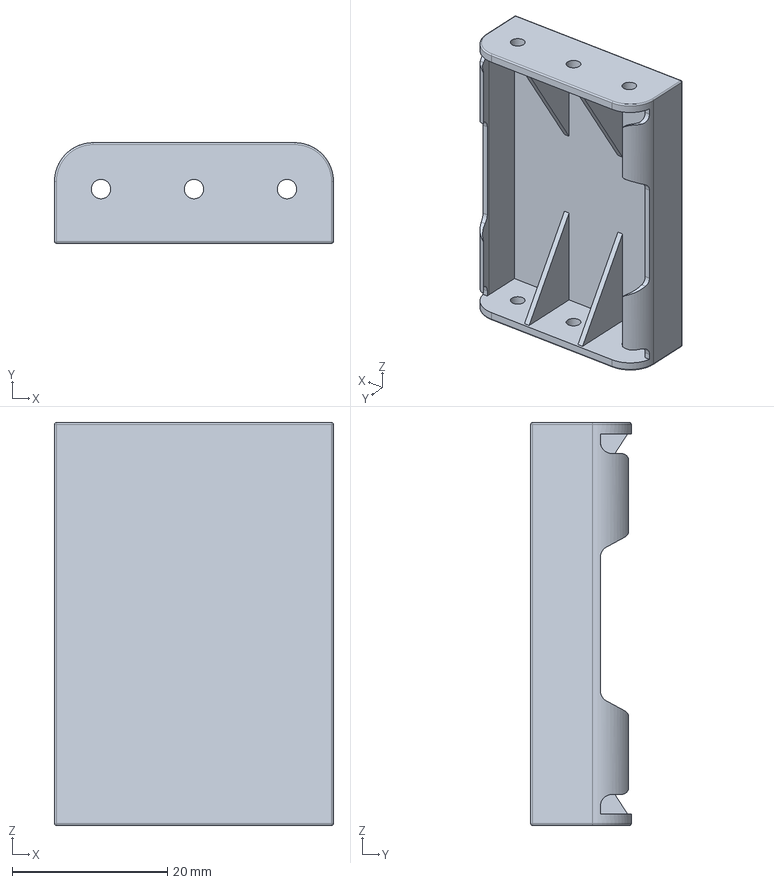
[picture p13: CAD file, 2024-02-26]
hardware/3D/3x AAA battery holder.stp
36.0 x 13.0 x 52.0 mm
