ElectronicCats/Minino/hardware/3D/HRO  TYPE-C-31-M-12.step

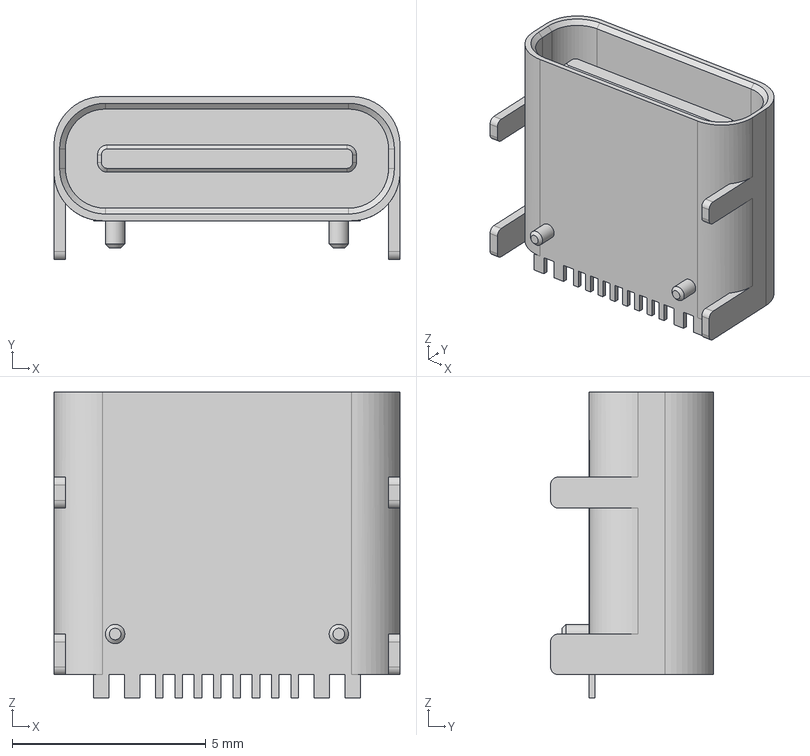
[picture p14: CAD file, 2024-02-26]
hardware/3D/HRO TYPE-C-31-M-12.step
8.94 x 4.21 x 7.90 mm
