ElectronicCats/Minino/hardware/3D/JS102011SAQN.STEP

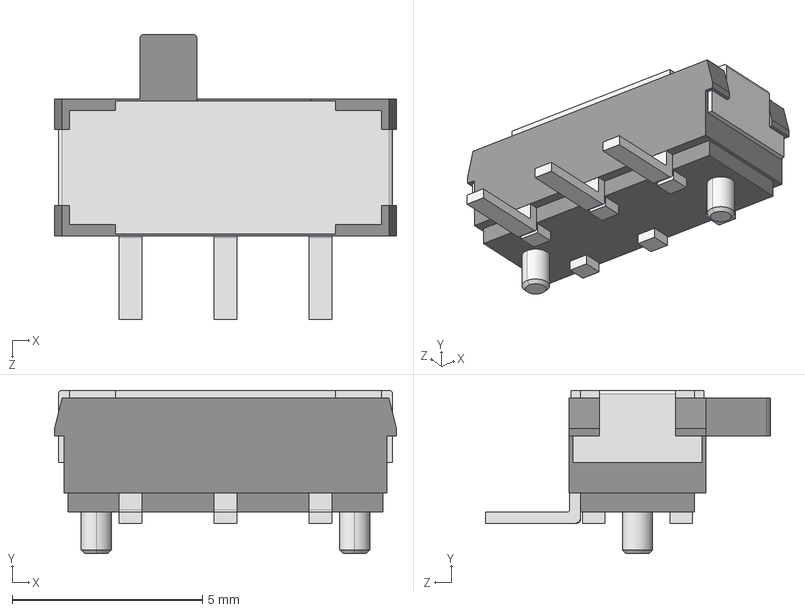
[picture p16: CAD file, 2022-12-08]
hardware/3D/JS102011SAQN.STEP
9.00 x 4.30 x 7.50 mm
