ElectronicCats/Minino/(threads)

Thread 3 (2024-07-25):

Issue with flashing firmware v1.0.2.0 on Minino

roozea, 2024-07-25:
# Issue with flashing firmware v1.0.2.0 on Minino

## Problem Description
When flashing the v1.0.2.0 firmware using the `build_files.zip` file, the device does not start correctly. There is no animation on the screen, no sound produced, and the flash LED does not blink after resetting the device.

However, when using the `test_build_files.zip` file from the same version, the device behaves differently.

## Steps to Reproduce
1. Downloaded `build_files.zip` and `test_build_files.zip` files from version v1.0.2.0.
2. Followed the flashing instructions from the [official Minino wiki](https://github.com/ElectronicCats/Minino/wiki/2.-Get-Started#how-to-update-minino-firmware).
3. Used the following command for flashing:
   ```
   python3 -m esptool --chip esp32c6 -p /dev/cu.usbmodem101 -b 460800 --before=default_reset --after=hard_reset write_flash --flash_mode dio --flash_freq 80m --flash_size 8MB 0x0 bootloader/bootloader.bin 0x10000 minino.bin 0x8000 partition_table/partition-table.bin
   ```
4. Reset the device after flashing.

## Expected Behavior
The device should start correctly and display the normal user interface after flashing with `build_files.zip`.

## Actual Behavior
- With `build_files.zip`: No visible or audible response from the device.
- With `test_build_files.zip`: The device starts and performs the LED test, sound test, button test, and microSD test. After these tests, it displays a screen with the following information:
  - Signal: None
  - Date: 2025/78/24
  - Time: 49:67:52
  The device then remains on this signal screen, continuously refreshing the displayed information.

## Environment
- Firmware version: v1.0.2.0
- Operating system: MacOS 15
- Flashing tool: esptool (installed via brew)

## Additional Information
Is there any additional step needed for the firmware from `build_files.zip` to work correctly? Could there be an issue with the files in `build_files.zip`?

Eric286, 2024-07-25:
Hello @roozea

Thank you very much for letting us know this, we have carried out some tests and I recommend you download the latest published version, which is version 1.0.2.1.

Likewise, if you have the same or a different problem, please let me know.

https://github.com/ElectronicCats/Minino/releases

Have a nice Day!

roozea, 2024-07-25:
Thank you for your assistance with this issue. I'm pleased to report that the problem has been resolved with a new firmware version provided.

After flashing the new firmware, the device is now functioning correctly. It initializes properly, entering normal operation mode as expected.

I appreciate the prompt attention and resolution to this issue.

Given that this issue is now resolved, I'll be closing it. Thank you again for your support.

Closed 2024-07-25.

Thread 12 (2024-10-09):

Make compile throwing some errors when following Developer guide

Alevsk, 2024-10-09:
I'm following the [developer guide](https://github.com/ElectronicCats/Minino/blob/main/firmware/README.md#building-the-firmware) for building the firmware until the `make compile` part where I'm stuck getting an error. I made sure I have all the developer tools and environment properly configured before compiling the firmware.

```bash
make compile                                                                       19:03:32
idf.py build
Executing action: all (aliases: build)
Running ninja in directory /home/alevsk/Development/Minino/firmware/build
Executing "ninja all"...
[0/1] Re-running CMake...
-- Building ESP-IDF components for target esp32c6
Using component placed at /home/alevsk/Development/Minino/firmware/components/OTA for dependency "OTA", specified in /home/alevsk/Development/Minino/firmware/main/idf_component.yml
Using component placed at /home/alevsk/Development/Minino/firmware/components/ble_hid for dependency "ble_hid", specified in /home/alevsk/Development/Minino/firmware/main/idf_component.yml
Using component placed at /home/alevsk/Development/Minino/firmware/components/ieee802154 for dependency "ieee802154", specified in /home/alevsk/Development/Minino/firmware/main/idf_component.yml
Using component placed at /home/alevsk/Development/Minino/firmware/components/openthread for dependency "openthread", specified in /home/alevsk/Development/Minino/firmware/main/idf_component.yml
Processing 11 dependencies:
[11/11] idf (5.4.0)
-- Project sdkconfig file /home/alevsk/Development/Minino/firmware/sdkconfig
Loading defaults file /home/alevsk/Development/Minino/firmware/sdkconfig.defaults...
warning: unknown kconfig symbol 'IEEE802154_RECEIVE_DONE_HANDLER' assigned to 'y' in /home/alevsk/Development/Minino/firmware/sdkconfig.defaults
warning: unknown kconfig symbol 'EXAMPLE_USE_INTERNAL_ETHERNET' assigned to 'n' in /home/alevsk/Development/Minino/firmware/sdkconfig.defaults
warning: unknown kconfig symbol 'EXAMPLE_USE_SPI_ETHERNET' assigned to 'n' in /home/alevsk/Development/Minino/firmware/sdkconfig.defaults
-- Adding linker script /home/alevsk/Development/esp-idf/components/riscv/ld/rom.api.ld
-- App "minino" version: v1.2.0.1
-- Adding linker script /home/alevsk/Development/Minino/firmware/build/esp-idf/esp_system/ld/memory.ld
-- Adding linker script /home/alevsk/Development/Minino/firmware/build/esp-idf/esp_system/ld/sections.ld.in
-- Adding linker script /home/alevsk/Development/esp-idf/components/esp_rom/esp32c6/ld/esp32c6.rom.ld
-- Adding linker script /home/alevsk/Development/esp-idf/components/esp_rom/esp32c6/ld/esp32c6.rom.api.ld
-- Adding linker script /home/alevsk/Development/esp-idf/components/esp_rom/esp32c6/ld/esp32c6.rom.rvfp.ld
-- Adding linker script /home/alevsk/Development/esp-idf/components/esp_rom/esp32c6/ld/esp32c6.rom.wdt.ld
-- Adding linker script /home/alevsk/Development/esp-idf/components/esp_rom/esp32c6/ld/esp32c6.rom.systimer.ld
-- Adding linker script /home/alevsk/Development/esp-idf/components/esp_rom/esp32c6/ld/esp32c6.rom.version.ld
-- Adding linker script /home/alevsk/Development/esp-idf/components/esp_rom/esp32c6/ld/esp32c6.rom.phy.ld
-- Adding linker script /home/alevsk/Development/esp-idf/components/esp_rom/esp32c6/ld/esp32c6.rom.coexist.ld
-- Adding linker script /home/alevsk/Development/esp-idf/components/esp_rom/esp32c6/ld/esp32c6.rom.net80211.ld
-- Adding linker script /home/alevsk/Development/esp-idf/components/esp_rom/esp32c6/ld/esp32c6.rom.pp.ld
-- Adding linker script /home/alevsk/Development/esp-idf/components/esp_rom/esp32c6/ld/esp32c6.rom.newlib.ld
-- Adding linker script /home/alevsk/Development/esp-idf/components/esp_rom/esp32c6/ld/esp32c6.rom.newlib-normal.ld
-- Adding linker script /home/alevsk/Development/esp-idf/components/esp_rom/esp32c6/ld/esp32c6.rom.heap.ld
-- Adding linker script /home/alevsk/Development/esp-idf/components/soc/esp32c6/ld/esp32c6.peripherals.ld
-- BUTTON: 3.3.1
6e5a178b31-8bd7c11-1.5.0-2024-10-09 02:03:47 UTC
-- Components: OTA app_trace app_update ble_hid bootloader bootloader_support bt bt_gattc bt_gatts bt_spam buzzer cmd_wifi cmock console cxx dns_server driver efuse esp-tls esp_adc esp_app_format esp_bootloader_format esp_coex esp_common esp_driver_ana_cmpr esp_driver_cam esp_driver_dac esp_driver_gpio esp_driver_gptimer esp_driver_i2c esp_driver_i2s esp_driver_isp esp_driver_jpeg esp_driver_ledc esp_driver_mcpwm esp_driver_parlio esp_driver_pcnt esp_driver_ppa esp_driver_rmt esp_driver_sdio esp_driver_sdm esp_driver_sdmmc esp_driver_sdspi esp_driver_spi esp_driver_touch_sens esp_driver_tsens esp_driver_uart esp_driver_usb_serial_jtag esp_eth esp_event esp_gdbstub esp_hid esp_http_client esp_http_server esp_https_ota esp_https_server esp_hw_support esp_lcd esp_local_ctrl esp_mm esp_netif esp_netif_stack esp_partition esp_phy esp_pm esp_psram esp_ringbuf esp_rom esp_security esp_system esp_timer esp_vfs_console esp_wifi espcoredump espressif__button espressif__cmake_utilities espressif__esp-zboss-lib espressif__esp-zigbee-lib espressif__iperf espressif__pcap esptool_py fatfs files_ops flash_fs freertos hal heap http_parser idf_test ieee802154 ieee_sniffer json ledc_controller leds log lwip main mbedtls minino_config mqtt newlib nmea_parser nvs_flash nvs_sec_provider open_thread openthread partition_table preferences protobuf-c protocomm pthread radio_selector riscv rt sd_card sdmmc soc spi_flash spiffs tcp_transport thread_broadcast trackers_scanner uart_sender ulp unity usb vfs wear_levelling wifi_app wifi_attacks wifi_captive wifi_controller wifi_provisioning wifi_scanner wifi_sniffer wpa_supplicant zigbee_switch
-- Component paths: /home/alevsk/Development/Minino/firmware/components/OTA /home/alevsk/Development/esp-idf/components/app_trace /home/alevsk/Development/esp-idf/components/app_update /home/alevsk/Development/Minino/firmware/components/ble_hid /home/alevsk/Development/esp-idf/components/bootloader 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
-- Configuring done
-- Generating done
-- Build files have been written to: /home/alevsk/Development/Minino/firmware/build
[1/1] cd /home/alevsk/Development/Minino/firmware/build/bootloa...vsk/Development/Minino/firmware/build/bootloader/bootloader.bin
Bootloader binary size 0x4d60 bytes. 0x32a0 bytes (40%) free.
[21/940] Building C object esp-idf/openthread/CMakeFiles/__idf_openthread.dir/src/port/esp_openthread_spi_slave.c.obj
FAILED: esp-idf/openthread/CMakeFiles/__idf_openthread.dir/src/port/esp_openthread_spi_slave.c.obj
/home/alevsk/.espressif/tools/riscv32-esp-elf/esp-14.2.0_20240906/riscv32-esp-elf/bin/riscv32-esp-elf-gcc -DESP_PLATFORM -DIDF_VER=\"v5.4-dev-3489-g6e5a178b31-dirty\" -DMBEDTLS_CONFIG_FILE=\"mbedtls/esp_config.h\" -DOPENTHREAD_BUILD_DATETIME="\" 2024-10-09 02:03:47 UTC\"" -DOPENTHREAD_CONFIG_FILE=\"openthread-core-esp32x-ftd-config.h\" -DOPENTHREAD_FTD=1 -DPACKAGE_VERSION=\"8bd7c11-8bd7c11\" -DSOC_MMU_PAGE_SIZE=CONFIG_MMU_PAGE_SIZE -DSOC_XTAL_FREQ_MHZ=CONFIG_XTAL_FREQ -D_GLIBCXX_HAVE_POSIX_SEMAPHORE -D_GLIBCXX_USE_POSIX_SEMAPHORE -D_GNU_SOURCE -D_POSIX_READER_WRITER_LOCKS -I/home/alevsk/Development/Minino/firmware/build/config -I/home/alevsk/Development/Minino/firmware/components/openthread/include -I/home/alevsk/Development/Minino/firmware/components/openthread/openthread/include -I/home/alevsk/Development/Minino/firmware/components/openthread/openthread/examples/platforms -I/home/alevsk/Development/Minino/firmware/components/openthread/openthread/include/openthread -I/home/alevsk/Development/Minino/firmware/components/openthread/openthread/src -I/home/alevsk/Development/Minino/firmware/components/openthread/openthread/src/core -I/home/alevsk/Development/Minino/firmware/components/openthread/openthread/src/lib -I/home/alevsk/Development/Minino/firmware/components/openthread/openthread/src/lib/hdlc -I/home/alevsk/Development/Minino/firmware/components/openthread/openthread/src/lib/spinel -I/home/alevsk/Development/Minino/firmware/components/openthread/openthread/src/ncp -I/home/alevsk/Development/Minino/firmware/components/openthread/private_include -I/home/alevsk/Development/esp-idf/components/newlib/platform_include -I/home/alevsk/Development/esp-idf/components/freertos/config/include -I/home/alevsk/Development/esp-idf/components/freertos/config/include/freertos -I/home/alevsk/Development/esp-idf/components/freertos/config/riscv/include -I/home/alevsk/Development/esp-idf/components/freertos/FreeRTOS-Kernel/include -I/home/alevsk/Development/esp-idf/components/freertos/FreeRTOS-Kernel/portable/riscv/include -I/home/alevsk/Development/esp-idf/components/freertos/FreeRTOS-Kernel/portable/riscv/include/freertos -I/home/alevsk/Development/esp-idf/components/freertos/esp_additions/include -I/home/alevsk/Development/esp-idf/components/esp_hw_support/include -I/home/alevsk/Development/esp-idf/components/esp_hw_support/include/soc -I/home/alevsk/Development/esp-idf/components/esp_hw_support/include/soc/esp32c6 -I/home/alevsk/Development/esp-idf/components/esp_hw_support/dma/include -I/home/alevsk/Development/esp-idf/components/esp_hw_support/ldo/include -I/home/alevsk/Development/esp-idf/components/esp_hw_support/debug_probe/include -I/home/alevsk/Development/esp-idf/components/esp_hw_support/port/esp32c6/. -I/home/alevsk/Development/esp-idf/components/esp_hw_support/port/esp32c6/include -I/home/alevsk/Development/esp-idf/components/esp_hw_support/port/esp32c6/private_include -I/home/alevsk/Development/esp-idf/components/heap/include -I/home/alevsk/Development/esp-idf/components/heap/tlsf -I/home/alevsk/Development/esp-idf/components/log/include -I/home/alevsk/Development/esp-idf/components/soc/include -I/home/alevsk/Development/esp-idf/components/soc/esp32c6 -I/home/alevsk/Development/esp-idf/components/soc/esp32c6/include -I/home/alevsk/Development/esp-idf/components/soc/esp32c6/register -I/home/alevsk/Development/esp-idf/components/hal/platform_port/include -I/home/alevsk/Development/esp-idf/components/hal/esp32c6/include -I/home/alevsk/Development/esp-idf/components/hal/include -I/home/alevsk/Development/esp-idf/components/esp_rom/include -I/home/alevsk/Development/esp-idf/components/esp_rom/esp32c6/include -I/home/alevsk/Development/esp-idf/components/esp_rom/esp32c6/include/esp32c6 -I/home/alevsk/Development/esp-idf/components/esp_rom/esp32c6 -I/home/alevsk/Development/esp-idf/components/esp_common/include -I/home/alevsk/Development/esp-idf/components/esp_system/include -I/home/alevsk/Development/esp-idf/components/esp_system/port/soc -I/home/alevsk/Development/esp-idf/components/esp_system/port/include/riscv -I/home/alevsk/Development/esp-idf/components/esp_system/port/include/private -I/home/alevsk/Development/esp-idf/components/riscv/include -I/home/alevsk/Development/esp-idf/components/lwip/include -I/home/alevsk/Development/esp-idf/components/lwip/include/apps -I/home/alevsk/Development/esp-idf/components/lwip/include/apps/sntp -I/home/alevsk/Development/esp-idf/components/lwip/lwip/src/include -I/home/alevsk/Development/esp-idf/components/lwip/port/include -I/home/alevsk/Development/esp-idf/components/lwip/port/freertos/include -I/home/alevsk/Development/esp-idf/components/lwip/port/esp32xx/include -I/home/alevsk/Development/esp-idf/components/lwip/port/esp32xx/include/arch -I/home/alevsk/Development/esp-idf/components/lwip/port/esp32xx/include/sys -I/home/alevsk/Development/esp-idf/components/esp_netif/include -I/home/alevsk/Development/esp-idf/components/esp_event/include -I/home/alevsk/Development/esp-idf/components/esp_driver_uart/include -I/home/alevsk/Development/esp-idf/components/vfs/include -I/home/alevsk/Development/esp-idf/components/driver/deprecated -I/home/alevsk/Development/esp-idf/components/driver/i2c/include -I/home/alevsk/Development/esp-idf/components/driver/touch_sensor/include -I/home/alevsk/Development/esp-idf/components/driver/twai/include -I/home/alevsk/Development/esp-idf/components/esp_pm/include -I/home/alevsk/Development/esp-idf/components/esp_ringbuf/include -I/home/alevsk/Development/esp-idf/components/esp_driver_gpio/include -I/home/alevsk/Development/esp-idf/components/esp_driver_pcnt/include -I/home/alevsk/Development/esp-idf/components/esp_driver_gptimer/include -I/home/alevsk/Development/esp-idf/components/esp_driver_spi/include -I/home/alevsk/Development/esp-idf/components/esp_driver_mcpwm/include -I/home/alevsk/Development/esp-idf/components/esp_driver_ana_cmpr/include -I/home/alevsk/Development/esp-idf/components/esp_driver_i2s/include -I/home/alevsk/Development/esp-idf/components/esp_driver_sdmmc/include -I/home/alevsk/Development/esp-idf/components/sdmmc/include -I/home/alevsk/Development/esp-idf/components/esp_driver_sdspi/include -I/home/alevsk/Development/esp-idf/components/esp_driver_sdio/include -I/home/alevsk/Development/esp-idf/components/esp_driver_dac/include -I/home/alevsk/Development/esp-idf/components/esp_driver_rmt/include -I/home/alevsk/Development/esp-idf/components/esp_driver_tsens/include -I/home/alevsk/Development/esp-idf/components/esp_driver_sdm/include -I/home/alevsk/Development/esp-idf/components/esp_driver_i2c/include -I/home/alevsk/Development/esp-idf/components/esp_driver_ledc/include -I/home/alevsk/Development/esp-idf/components/esp_driver_parlio/include -I/home/alevsk/Development/esp-idf/components/esp_driver_usb_serial_jtag/include -I/home/alevsk/Development/esp-idf/components/console -I/home/alevsk/Development/esp-idf/components/esp_vfs_console/include -I/home/alevsk/Development/esp-idf/components/esp_partition/include -I/home/alevsk/Development/esp-idf/components/esp_timer/include -I/home/alevsk/Development/Minino/firmware/components/ieee802154/include -I/home/alevsk/Development/esp-idf/components/mbedtls/port/include -I/home/alevsk/Development/esp-idf/components/mbedtls/mbedtls/include -I/home/alevsk/Development/esp-idf/components/mbedtls/mbedtls/library -I/home/alevsk/Development/esp-idf/components/mbedtls/esp_crt_bundle/include -I/home/alevsk/Development/esp-idf/components/mbedtls/mbedtls/3rdparty/everest/include -I/home/alevsk/Development/esp-idf/components/mbedtls/mbedtls/3rdparty/p256-m -I/home/alevsk/Development/esp-idf/components/mbedtls/mbedtls/3rdparty/p256-m/p256-m -I/home/alevsk/Development/esp-idf/components/nvs_flash/include -march=rv32imac_zicsr_zifencei  -fdiagnostics-color=always -ffunction-sections -fdata-sections -Wall -Werror=all -Wno-error=unused-function -Wno-error=unused-variable -Wno-error=unused-but-set-variable -Wno-error=deprecated-declarations -Wextra -Wno-error=extra -Wno-unused-parameter -Wno-sign-compare -Wno-enum-conversion -gdwarf-4 -ggdb -nostartfiles -Og -fno-shrink-wrap -fmacro-prefix-map=/home/alevsk/Development/Minino/firmware=. -fmacro-prefix-map=/home/alevsk/Development/esp-idf=/IDF -fstrict-volatile-bitfields -fno-jump-tables -fno-tree-switch-conversion -std=gnu17 -Wno-old-style-declaration -MD -MT esp-idf/openthread/CMakeFiles/__idf_openthread.dir/src/port/esp_openthread_spi_slave.c.obj -MF esp-idf/openthread/CMakeFiles/__idf_openthread.dir/src/port/esp_openthread_spi_slave.c.obj.d -o esp-idf/openthread/CMakeFiles/__idf_openthread.dir/src/port/esp_openthread_spi_slave.c.obj -c /home/alevsk/Development/Minino/firmware/components/openthread/src/port/esp_openthread_spi_slave.c
/home/alevsk/Development/Minino/firmware/components/openthread/src/port/esp_openthread_spi_slave.c:29:10: fatal error: esp_private/cache_utils.h: No such file or directory
   29 | #include "esp_private/cache_utils.h"
      |          ^~~~~~~~~~~~~~~~~~~~~~~~~~~
compilation terminated.
[34/940] Building CXX object esp-idf/openthread/CMakeFiles/__id...nthread.dir/openthread/src/core/api/backbone_router_api.cpp.obj
ninja: build stopped: subcommand failed.
Compilation failed because esp_openthread_spi_slave.c (in "openthread" component) includes esp_private/cache_utils.h, provided by spi_flash component(s).
However, spi_flash component(s) is not in the requirements list of "openthread".
To fix this, add spi_flash to PRIV_REQUIRES list of idf_component_register call in /home/alevsk/Development/Minino/firmware/components/openthread/CMakeLists.txt.
ninja failed with exit code 1, output of the command is in the /home/alevsk/Development/Minino/firmware/build/log/idf_py_stderr_output_172439 and /home/alevsk/Development/Minino/firmware/build/log/idf_py_stdout_output_172439
make: *** [Makefile:9: compile] Error 2
```

If adding the `spi_flash` component into the `PRIV_REQUIRES` list inside the `/home/alevsk/Development/Minino/firmware/components/openthread/CMakeLists.txt` file as the error suggest then I'm facing additional errors.

```bash
make compile                                                                25s 19:07:36
idf.py build
Executing action: all (aliases: build)
Running ninja in directory /home/alevsk/Development/Minino/firmware/build
Executing "ninja all"...
[0/1] Re-running CMake...
-- Building ESP-IDF components for target esp32c6
Using component placed at /home/alevsk/Development/Minino/firmware/components/OTA for dependency "OTA", specified in /home/alevsk/Development/Minino/firmware/main/idf_component.yml
Using component placed at /home/alevsk/Development/Minino/firmware/components/ble_hid for dependency "ble_hid", specified in /home/alevsk/Development/Minino/firmware/main/idf_component.yml
Using component placed at /home/alevsk/Development/Minino/firmware/components/ieee802154 for dependency "ieee802154", specified in /home/alevsk/Development/Minino/firmware/main/idf_component.yml
Using component placed at /home/alevsk/Development/Minino/firmware/components/openthread for dependency "openthread", specified in /home/alevsk/Development/Minino/firmware/main/idf_component.yml
Processing 11 dependencies:
[11/11] idf (5.4.0)
-- Project sdkconfig file /home/alevsk/Development/Minino/firmware/sdkconfig
Loading defaults file /home/alevsk/Development/Minino/firmware/sdkconfig.defaults...
warning: unknown kconfig symbol 'IEEE802154_RECEIVE_DONE_HANDLER' assigned to 'y' in /home/alevsk/Development/Minino/firmware/sdkconfig.defaults
warning: unknown kconfig symbol 'EXAMPLE_USE_INTERNAL_ETHERNET' assigned to 'n' in /home/alevsk/Development/Minino/firmware/sdkconfig.defaults
warning: unknown kconfig symbol 'EXAMPLE_USE_SPI_ETHERNET' assigned to 'n' in /home/alevsk/Development/Minino/firmware/sdkconfig.defaults
-- Adding linker script /home/alevsk/Development/esp-idf/components/riscv/ld/rom.api.ld
-- App "minino" version: v1.2.0.1-dirty
-- Adding linker script /home/alevsk/Development/Minino/firmware/build/esp-idf/esp_system/ld/memory.ld
-- Adding linker script /home/alevsk/Development/Minino/firmware/build/esp-idf/esp_system/ld/sections.ld.in
-- Adding linker script /home/alevsk/Development/esp-idf/components/esp_rom/esp32c6/ld/esp32c6.rom.ld
-- Adding linker script /home/alevsk/Development/esp-idf/components/esp_rom/esp32c6/ld/esp32c6.rom.api.ld
-- Adding linker script /home/alevsk/Development/esp-idf/components/esp_rom/esp32c6/ld/esp32c6.rom.rvfp.ld
-- Adding linker script /home/alevsk/Development/esp-idf/components/esp_rom/esp32c6/ld/esp32c6.rom.wdt.ld
-- Adding linker script /home/alevsk/Development/esp-idf/components/esp_rom/esp32c6/ld/esp32c6.rom.systimer.ld
-- Adding linker script /home/alevsk/Development/esp-idf/components/esp_rom/esp32c6/ld/esp32c6.rom.version.ld
-- Adding linker script /home/alevsk/Development/esp-idf/components/esp_rom/esp32c6/ld/esp32c6.rom.phy.ld
-- Adding linker script /home/alevsk/Development/esp-idf/components/esp_rom/esp32c6/ld/esp32c6.rom.coexist.ld
-- Adding linker script /home/alevsk/Development/esp-idf/components/esp_rom/esp32c6/ld/esp32c6.rom.net80211.ld
-- Adding linker script /home/alevsk/Development/esp-idf/components/esp_rom/esp32c6/ld/esp32c6.rom.pp.ld
-- Adding linker script /home/alevsk/Development/esp-idf/components/esp_rom/esp32c6/ld/esp32c6.rom.newlib.ld
-- Adding linker script /home/alevsk/Development/esp-idf/components/esp_rom/esp32c6/ld/esp32c6.rom.newlib-normal.ld
-- Adding linker script /home/alevsk/Development/esp-idf/components/esp_rom/esp32c6/ld/esp32c6.rom.heap.ld
-- Adding linker script /home/alevsk/Development/esp-idf/components/soc/esp32c6/ld/esp32c6.peripherals.ld
-- BUTTON: 3.3.1
6e5a178b31-8bd7c11-1.5.0-2024-10-09 02:07:45 UTC
-- Components: OTA app_trace app_update ble_hid bootloader bootloader_support bt bt_gattc bt_gatts bt_spam buzzer cmd_wifi cmock console cxx dns_server driver efuse esp-tls esp_adc esp_app_format esp_bootloader_format esp_coex esp_common esp_driver_ana_cmpr esp_driver_cam esp_driver_dac esp_driver_gpio esp_driver_gptimer esp_driver_i2c esp_driver_i2s esp_driver_isp esp_driver_jpeg esp_driver_ledc esp_driver_mcpwm esp_driver_parlio esp_driver_pcnt esp_driver_ppa esp_driver_rmt esp_driver_sdio esp_driver_sdm esp_driver_sdmmc esp_driver_sdspi esp_driver_spi esp_driver_touch_sens esp_driver_tsens esp_driver_uart esp_driver_usb_serial_jtag esp_eth esp_event esp_gdbstub esp_hid esp_http_client esp_http_server esp_https_ota esp_https_server esp_hw_support esp_lcd esp_local_ctrl esp_mm esp_netif esp_netif_stack esp_partition esp_phy esp_pm esp_psram esp_ringbuf esp_rom esp_security esp_system esp_timer esp_vfs_console esp_wifi espcoredump espressif__button espressif__cmake_utilities espressif__esp-zboss-lib espressif__esp-zigbee-lib espressif__iperf espressif__pcap esptool_py fatfs files_ops flash_fs freertos hal heap http_parser idf_test ieee802154 ieee_sniffer json ledc_controller leds log lwip main mbedtls minino_config mqtt newlib nmea_parser nvs_flash nvs_sec_provider open_thread openthread partition_table preferences protobuf-c protocomm pthread radio_selector riscv rt sd_card sdmmc soc spi_flash spiffs tcp_transport thread_broadcast trackers_scanner uart_sender ulp unity usb vfs wear_levelling wifi_app wifi_attacks wifi_captive wifi_controller wifi_provisioning wifi_scanner wifi_sniffer wpa_supplicant zigbee_switch
-- Component paths: /home/alevsk/Development/Minino/firmware/components/OTA /home/alevsk/Development/esp-idf/components/app_trace /home/alevsk/Development/esp-idf/components/app_update /home/alevsk/Development/Minino/firmware/components/ble_hid
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

Thread 19 (2025-01-31):

Enclosure for 3D-print?

alfs, 2025-01-31:
Is there an enclosure for the Minino board available for 3D-printing?

I looked around but could not find any.

Elizabeth-0, 2025-02-05:
Hello @alfs,

Thank you for contacting us.

At the moment we do not have a case for Minino, but our team is actively working on it. Please stay tuned to our social media channels for updates, as we'll be sharing exciting news about new cases for our products soon!

Feel free to contact us if you have any further questions or if you'd like to close this issue.

Have a great day!

Closed 2025-02-06.

Thread 21 (2025-02-20):

wifi:Channel number 13 is out of range from 1 to 11 in country code cc=01

klamath1977, 2025-02-20:
When I Try to deauth my wifi network for test, i get cc error,

Can I change the country code in accordin with my location?

E (29702) wifi:Channel number 13 is out of range from 1 to 11 in country code cc=01 .
E (29702) wifi_controllera:main: Error setting WiFi Access Point configuration: ESP_ERR_INVALID_ARG

JahazielLem, 2025-02-20:
Hi @klamath1977,

We are currently working on this issue and believe we have a patch for it. However, before proceeding, could you provide more details about your country code? Based on the logs, I assume you're in Japan or Europe, given the channel range you're using. Also, did you compile the code yourself?

In our production builds, we typically disable logs, so this behavior might differ from what you're seeing.

Looking forward to your response!
Regards

klamath1977, 2025-02-21:
Hello @JahazielLem,
I came from Europe/Italy,
and yes, I can compile the code from myself, I have a macbook pro with macos 15 and yesterday I have installed esp-idf v5.3.1 and all I need to compile minino in according with minino developer wiki.
I just test it and work wery well.

thanks for fast reply, I'm waiting your forward.
Regards

JahazielLem, 2025-02-21:
Hello @klamath1977
I created a branch named contrycode (sorry for the typo). In this branch, I added the necessary code to set up the country code for Europe and Japan. It would be great if you could compile and test this branch.

I believe this should work, but due to our country's limitations, we can't be completely sure until it's tested in a European or Japanese region. You don't need to do anything else—just compile, upload the code, and try running the deauth app again.

Let me know how it goes!

klamath1977, 2025-02-22:
Hi @JahazielLem
I compile contrycode branch, and seem to be work with wifi channel 12, 13 and 14.
I just edit firmware/components/wifi_controller/wifi_controller.c

`wifi_country_t conf/ig = {
      .cc = "IT",   ----------- > #change JP to IT
      .schan = 1,
      .nchan = 14,
      .policy = WIFI_COUNTRY_POLICY_AUTO,`

[minino-noota-firmware-1.1.7.1cc-it.zip](https://github.com/user-attachments/files/18919782/minino-noota-firmware-1.1.7.1cc-it.zip)
[minino-ota-firmware-1.1.7.1cc-it.zip](https://github.com/user-attachments/files/18919781/minino-ota-firmware-1.1.7.1cc-it.zip)

thanks

klamath1977, 2025-02-26:
I have compile new contrycode commit (thanks @Otrebor671)
And now I can change contrycode direct from minino menu.

great!

JahazielLem, 2025-02-26:
@klamath1977 Nice! Thanks for testing the commit, your feedback helps us with the implementation of this configuration.

We will be releasing version 1.1.7.2 in the coming days.

If you encounter any further issues with frequencies or country codes in the applications, please let us know.
Regards

Closed 2025-02-26.

Thread 42 (2025-06-29):

Error al guardar archivos de warfi

DeimosHall, 2025-06-29:
Es posible que haya algún problema con el nombre de la red, no creo que sean los espacios porque ya revisé y sí que hay redes que en el SSID contienen espacios. El problema es que genera el archivo con una columna extra como se ve en la imagen.

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

Closed 2025-08-05.

Thread 50 (2025-07-14):

Mejoras en captive portal

sabas1080, 2025-07-14:
- [ ] Poder cambiar la pagina de redireccionque va al final del send, asi como la root
- [ ] Poder cambiar el nombre del AP desde terminal o pantalla,
- [ ] El nombre de default no debe ser MININO_AP siempre, en talleres esa hace conflicto, pudiera ser MININO-ID del ESP32,
- [ ] Creo es posible tal vez poder usar como AP y como estación para poder brindar internet al usuario o poder cargar cosas desde internet si estas conectado a una red wifi

sabas1080, 2025-07-17:
me gustaria poder personalizar la ventana que es ahora el "mensaje de texto" por otro texto o por otra pagina html, es proceso seria:
Pagina de Formulario (root.html) -> Se llena el formulario-> send -> Pagina de bienvenida o registro exitoso (home.html o pesonalizar el texto actual)

JahazielLem, 2025-07-17:
Se puede hacer cualquiera de los dos, solo dime cual se deja, porque una sobreescribiria a la otra y cual seria el alcance, por ejemplo:
Folder para captive portal y folder para reedirects y que puedas seleccionar cada uno, o solo un reedirect y que se tenga que estar actualizando para cambiarlo

JahazielLem, 2025-07-17:
El PR #58 Permite cambiar el nombre de la AP por default usando el comando `captive_name`, limitaciones:
100 caracteres como maximo y no acepta espacios.
Tambien cambia el default AP por lo que se configure con idf por ejemplo "MININO_AP" y le agrega dos bytes de la mac dejando algo como "MININO_AP_00:00" asiendo unico. Este nombre se muestra en la pantalla del minino

sabas1080, 2025-07-17:
> Se puede hacer cualquiera de los dos, solo dime cual se deja, porque una sobreescribiria a la otra y cual seria el alcance, por ejemplo: Folder para captive portal y folder para reedirects y que puedas seleccionar cada uno, o solo un reedirect y que se tenga que estar actualizando para cambiarlo

Folder para captive y folder para reedirects por favor

Thread 59 (2025-07-18):

Wardriving con google heart

R44wk, 2025-07-18:
Hola,
Como puedo tener soporte con minino para archivos kml para usarlos en google heart y/o kismet, estaria buenisimo ese nuevo feature.

Elizabeth-0, 2025-07-18:
Hola @R44wk  ,

¡Gracias por contactarnos!

Actualmente, Minino genera archivos .csv al utilizar la función de Wardriving, pero no te preocupes, puedes convertir fácilmente esos archivos a formato .kml para visualizarlos en Google Earth. En nuestra Wiki encontrarás una guía paso a paso para hacerlo con ayuda del sitio web Wigle: [Wardriving visualization](https://github.com/ElectronicCats/Minino/wiki/4.-Features#2-visualization)

En cuanto al soporte para herramientas como Kismet o la generación directa de archivos .kml desde Minino, estamos trabajando en nuevas funcionalidades y mejoras. ¡Agradecemos mucho tu sugerencia y la tomaremos en cuenta!

Si tienes cualquier otra duda o sugerencia, no dudes en escribirnos.

¡Bonito día!

REGIOIGER, 2025-07-24:
En una versión siguiente tendremos ese feature por lo pronto generando archivos gpx el cual puedes importar facilmente desde Google Earth, ya esta en pruebas ;)

Elizabeth-0, 2025-07-25:
Hola @R44wk,

Esperamos que la información te haya sido útil. Ahora cerraremos este issue, pero no dudes en contactarnos de nuevo si tienes alguna otra duda o problema.

¡Que tegas un buen fin de semana!✨
