ElectronicCats/Minino/firmware/components/nmea_parser/nmea_parser.c

/*
 * SPDX-FileCopyrightText: 2015-2022 Espressif Systems (Shanghai) CO LTD
 *
 * SPDX-License-Identifier: Apache-2.0
 */

#include "nmea_parser.h"
#include <ctype.h>
#include <math.h>
#include <stdlib.h>
#include <string.h>
#include "esp_log.h"
#include "freertos/FreeRTOS.h"
#include "freertos/task.h"
#include "task_manager.h"

/**
 * @brief NMEA Parser runtime buffer size
 *
 */
#define NMEA_PARSER_RUNTIME_BUFFER_SIZE \
  (CONFIG_NMEA_PARSER_RING_BUFFER_SIZE / 2)
#define NMEA_MAX_STATEMENT_ITEM_LENGTH (16)
#define NMEA_EVENT_LOOP_QUEUE_SIZE     (16)

/**
 * @brief Define of NMEA Parser Event base
 *
 */
ESP_EVENT_DEFINE_BASE(ESP_NMEA_EVENT);

static const char* TAG = "nmea_parser";

/**
 * @brief GPS parser library runtime structure
 *
 */
typedef struct {
  uint8_t item_pos;         /*!< Current position in item */
  uint8_t item_num;         /*!< Current item number */
  uint8_t asterisk;         /*!< Asterisk detected flag */
  uint8_t crc;              /*!< Calculated CRC value */
  uint8_t parsed_statement; /*!< OR'd of statements that have been parsed */
  uint8_t sat_num;          /*!< Satellite number */
  uint8_t sat_count;        /*!< Satellite count */
  uint8_t cur_statement;    /*!< Current statement ID */
  uint32_t all_statements;  /*!< All statements mask */
  char item_str[NMEA_MAX_STATEMENT_ITEM_LENGTH]; /*!< Current item */
  gps_t parent;                                  /*!< Parent class */
  uart_port_t uart_port;                         /*!< Uart port number */
  uint8_t* buffer;                               /*!< Runtime buffer */
  TaskHandle_t tsk_hdl;                          /*!< NMEA Parser task handle */
  QueueHandle_t event_queue;                     /*!< UART event queue handle */
  esp_event_handler_t event_handler; /*!< User event handler callback */
  void* event_handler_arg;           /*!< User event handler argument */
  volatile bool is_running;          /*!< Task running state flag */
  SemaphoreHandle_t task_done_sem;   /*!< Task completion semaphore */
} esp_gps_t;

/**
 * @brief parse latitude or longitude
 *              format of latitude in NMEA is ddmm.sss and longitude is
 * dddmm.sss
 * @param esp_gps esp_gps_t type object
 * @return float Latitude or Longitude value (unit: degree)
 */
static float parse_lat_long(esp_gps_t* esp_gps) {
  double ll = strtod(esp_gps->item_str, NULL);
  int deg = ((int) ll) / 100;
  double min = ll - (deg * 100);
  ll = deg + (min / 60.0);
  return (float) ll;
}

/**
 * @brief Converter two continuous numeric character into a uint8_t number
 *
 * @param digit_char numeric character
 * @return uint8_t result of converting
 */
static inline uint8_t convert_two_digit2number(const char* digit_char) {
  if (!isdigit((unsigned char) digit_char[0]) ||
      !isdigit((unsigned char) digit_char[1])) {
    return 0;
  }
  return (uint8_t) (10 * (digit_char[0] - '0') + (digit_char[1] - '0'));
}

/**
 * @brief Parse UTC time in GPS statements
 *
 * @param esp_gps esp_gps_t type object
 */
static void parse_utc_time(esp_gps_t* esp_gps) {
  size_t len = strlen(esp_gps->item_str);
  if (len < 6) {
    return;
  }
  esp_gps->parent.tim.hour = convert_two_digit2number(esp_gps->item_str + 0);
  esp_gps->parent.tim.minute = convert_two_digit2number(esp_gps->item_str + 2);
  esp_gps->parent.tim.second = convert_two_digit2number(esp_gps->item_str + 4);
  if (len > 6 && esp_gps->item_str[6] == '.') {
    uint16_t tmp = 0;
    uint8_t i = 7;
    uint8_t digits = 0;
    while (esp_gps->item_str[i] &&
           isdigit((unsigned char) esp_gps->item_str[i]) && digits < 3) {
      tmp = 10 * tmp + (esp_gps->item_str[i] - '0');
      i++;
      digits++;
    }
    while (digits++ < 3) {
      tmp *= 10;
    }
    esp_gps->parent.tim.thousand = tmp;
  }
}

#if CONFIG_NMEA_STATEMENT_GGA
/**
 * @brief Parse GGA statements
 *
 * @param esp_gps esp_gps_t type object
 */
static void parse_gga(esp_gps_t* esp_gps) {
  /* Process GGA statement */
  switch (esp_gps->item_num) {
    case 1: /* Process UTC time */
      parse_utc_time(esp_gps);
      break;
    case 2: /* Latitude */
      esp_gps->parent.latitude = parse_lat_long(esp_gps);
      break;
    case 3: /* Latitude north(1)/south(-1) information */
      if (esp_gps->item_str[0] == 'S' || esp_gps->item_str[0] == 's') {
        esp_gps->parent.latitude *= -1;
      }
      break;
    case 4: /* Longitude */
      esp_gps->parent.longitude = parse_lat_long(esp_gps);
      break;
    case 5: /* Longitude east(1)/west(-1) information */
      if (esp_gps->item_str[0] == 'W' || esp_gps->item_str[0] == 'w') {
        esp_gps->parent.longitude *= -1;
      }
      break;
    case 6: /* Fix status */
      esp_gps->parent.fix = (gps_fix_t) strtol(esp_gps->item_str, NULL, 10);
      break;
    case 7: /* Satellites in use */
      esp_gps->parent.sats_in_use =
          (uint8_t) strtol(esp_gps->item_str, NULL, 10);
      break;
    case 8: /* HDOP */
      esp_gps->parent.dop_h = strtof(esp_gps->item_str, NULL);
      break;
    case 9: /* Altitude */
      esp_gps->parent.altitude = strtof(esp_gps->item_str, NULL);
      break;
    case 11: /* Altitude above ellipsoid */
      esp_gps->parent.altitude += strtof(esp_gps->item_str, NULL);
      break;
    default:
      break;
  }
}
#endif

#if CONFIG_NMEA_STATEMENT_GSA
/**
 * @brief Parse GSA statements
 *
 * @param esp_gps esp_gps_t type object
 */
static void parse_gsa(esp_gps_t* esp_gps) {
  /* Process GSA statement */
  switch (esp_gps->item_num) {
    case 2: /* Process fix mode */
      esp_gps->parent.fix_mode =
          (gps_fix_mode_t) strtol(esp_gps->item_str, NULL, 10);
      break;
    case 15: /* Process PDOP */
      esp_gps->parent.dop_p = strtof(esp_gps->item_str, NULL);
      break;
    case 16: /* Process HDOP */
      esp_gps->parent.dop_h = strtof(esp_gps->item_str, NULL);
      break;
    case 17: /* Process VDOP */
      esp_gps->parent.dop_v = strtof(esp_gps->item_str, NULL);
      break;
    default:
      /* Parse satellite IDs */
      if (esp_gps->item_num >= 3 && esp_gps->item_num <= 14) {
        esp_gps->parent.sats_id_in_use[esp_gps->item_num - 3] =
            (uint8_t) strtol(esp_gps->item_str, NULL, 10);
      }
      break;
  }
}
#endif

#if CONFIG_NMEA_STATEMENT_GSV
/**
 * @brief Parse GSV statements
 *
 * @param esp_gps esp_gps_t type object
 */
static void parse_gsv(esp_gps_t* esp_gps) {
  /* Process GSV statement */
  switch (esp_gps->item_num) {
    case 1: /* total GSV numbers */
      esp_gps->sat_count = (uint8_t) strtol(esp_gps->item_str, NULL, 10);
      break;
    case 2: /* Current GSV statement number */
      esp_gps->sat_num = (uint8_t) strtol(esp_gps->item_str, NULL, 10);
      break;
    case 3: /* Process satellites in view */
      esp_gps->parent.sats_in_view =
          (uint8_t) strtol(esp_gps->item_str, NULL, 10);
      break;
    default:
      if (esp_gps->item_num >= 4 && esp_gps->item_num <= 19) {
        uint8_t item_num =
            esp_gps->item_num - 4; /* Normalize item number from 4-19 to 0-15 */
        uint8_t index;
        uint32_t value;
        index = 4 * (esp_gps->sat_num - 1) + item_num / 4; /* Get array index */
        if (index < GPS_MAX_SATELLITES_IN_VIEW) {
          value = strtol(esp_gps->item_str, NULL, 10);
          switch (item_num % 4) {
            case 0:
              esp_gps->parent.sats_desc_in_view[index].num = (uint8_t) value;
              break;
            case 1:
              esp_gps->parent.sats_desc_in_view[index].elevation =
                  (uint8_t) value;
              break;
            case 2:
              esp_gps->parent.sats_desc_in_view[index].azimuth =
                  (uint16_t) value;
              break;
            case 3:
              esp_gps->parent.sats_desc_in_view[index].snr = (uint8_t) value;
              break;
            default:
              break;
          }
        }
      }
      break;
  }
}
#endif

#if CONFIG_NMEA_STATEMENT_RMC
/**
 * @brief Parse RMC statements
 *
 * @param esp_gps esp_gps_t type object
 */
static void parse_rmc(esp_gps_t* esp_gps) {
  /* Process GPRMC statement */
  switch (esp_gps->item_num) {
    case 1: /* Process UTC time */
      parse_utc_time(esp_gps);
      break;
    case 2: /* Process valid status */
      esp_gps->parent.valid = (esp_gps->item_str[0] == 'A');
      break;
    case 3: /* Latitude */
      esp_gps->parent.latitude = parse_lat_long(esp_gps);
      break;
    case 4: /* Latitude north(1)/south(-1) information */
      if (esp_gps->item_str[0] == 'S' || esp_gps->item_str[0] == 's') {
        esp_gps->parent.latitude *= -1;
      }
      break;
    case 5: /* Longitude */
      esp_gps->parent.longitude = parse_lat_long(esp_gps);
      break;
    case 6: /* Longitude east(1)/west(-1) information */
      if (esp_gps->item_str[0] == 'W' || esp_gps->item_str[0] == 'w') {
        esp_gps->parent.longitude *= -1;
      }
      break;
    case 7: /* Process ground speed in unit m/s */
      esp_gps->parent.speed = strtof(esp_gps->item_str, NULL) * 1.852;
      break;
    case 8: /* Process true course over ground */
      esp_gps->parent.cog = strtof(esp_gps->item_str, NULL);
      break;
    case 9: /* Process date */
      esp_gps->parent.date.day =
          convert_two_digit2number(esp_gps->item_str + 0);
      esp_gps->parent.date.month =
          convert_two_digit2number(esp_gps->item_str + 2);
      esp_gps->parent.date.year =
          convert_two_digit2number(esp_gps->item_str + 4);
      break;
    case 10: /* Process magnetic variation */
      esp_gps->parent.variation = strtof(esp_gps->item_str, NULL);
      break;
    default:
      break;
  }
}
#endif

#if CONFIG_NMEA_STATEMENT_GLL
/**
 * @brief Parse GLL statements
 *
 * @param esp_gps esp_gps_t type object
 */
static void parse_gll(esp_gps_t* esp_gps) {
  /* Process GPGLL statement */
  switch (esp_gps->item_num) {
    case 1: /* Latitude */
      esp_gps->parent.latitude = parse_lat_long(esp_gps);
      break;
    case 2: /* Latitude north(1)/south(-1) information */
      if (esp_gps->item_str[0] == 'S' || esp_gps->item_str[0] == 's') {
        esp_gps->parent.latitude *= -1;
      }
      break;
    case 3: /* Longitude */
      esp_gps->parent.longitude = parse_lat_long(esp_gps);
      break;
    case 4: /* Longitude east(1)/west(-1) information */
      if (esp_gps->item_str[0] == 'W' || esp_gps->item_str[0] == 'w') {
        esp_gps->parent.longitude *= -1;
      }
      break;
    case 5: /* Process UTC time */
      parse_utc_time(esp_gps);
      break;
    case 6: /* Process valid status */
      esp_gps->parent.valid = (esp_gps->item_str[0] == 'A');
      break;
    default:
      break;
  }
}
#endif

#if CONFIG_NMEA_STATEMENT_VTG
/**
 * @brief Parse VTG statements
 *
 * @param esp_gps esp_gps_t type object
 */
static void parse_vtg(esp_gps_t* esp_gps) {
  /* Process GPVGT statement */
  switch (esp_gps->item_num) {
    case 1: /* Process true course over ground */
      esp_gps->parent.cog = strtof(esp_gps->item_str, NULL);
      break;
    case 3: /* Process magnetic variation */
      esp_gps->parent.variation = strtof(esp_gps->item_str, NULL);
      break;
    case 5: /* Process ground speed in unit m/s */
      esp_gps->parent.speed =
          strtof(esp_gps->item_str, NULL) * 1.852;  // knots to m/s
      break;
    case 7: /* Process ground speed in unit m/s */
      esp_gps->parent.speed =
          strtof(esp_gps->item_str, NULL) / 3.6;  // km/h to m/s
      break;
    default:
      break;
  }
}
#endif

/**
 * @brief Parse ZDA statements
 *
 * @param esp_gps esp_gps_t type object
 */
static void parse_zda(esp_gps_t* esp_gps) {
  /* Process ZDA statement */
  switch (esp_gps->item_num) {
    case 1: /* Process UTC time */
      parse_utc_time(esp_gps);
      break;
    case 2: /* Process date */
      esp_gps->parent.date.day =
          convert_two_digit2number(esp_gps->item_str + 0);
      esp_gps->parent.date.month =
          convert_two_digit2number(esp_gps->item_str + 2);
      esp_gps->parent.date.year =
          convert_two_digit2number(esp_gps->item_str + 4);
#if defined(CONFIG_NMEA_PARSER_DEBUG)
      ESP_LOGD(TAG, "ZDA date parsed: %d/%02d/%02d", esp_gps->parent.date.year,
               esp_gps->parent.date.month, esp_gps->parent.date.day);
#endif
      break;
    default:
      break;
  }
}

/**
 * @brief Parse received item
 *
 * @param esp_gps esp_gps_t type object
 * @return esp_err_t ESP_OK on success, ESP_FAIL on error
 */
static esp_err_t parse_item(esp_gps_t* esp_gps) {
  esp_err_t err = ESP_OK;
  /* start of a statement */
  if (esp_gps->item_num == 0 && esp_gps->item_str[0] == '$') {
    if (0) {
    }
#if CONFIG_NMEA_STATEMENT_GGA
    else if (strstr(esp_gps->item_str, "GGA")) {
      esp_gps->cur_statement = STATEMENT_GGA;
    }
#endif
#if CONFIG_NMEA_STATEMENT_GSA
    else if (strstr(esp_gps->item_str, "GSA")) {
      esp_gps->cur_statement = STATEMENT_GSA;
    }
#endif
#if CONFIG_NMEA_STATEMENT_RMC
    else if (strstr(esp_gps->item_str, "RMC")) {
      esp_gps->cur_statement = STATEMENT_RMC;
    }
#endif
#if CONFIG_NMEA_STATEMENT_GSV
    else if (strstr(esp_gps->item_str, "GSV")) {
      esp_gps->cur_statement = STATEMENT_GSV;
    }
#endif
#if CONFIG_NMEA_STATEMENT_GLL
    else if (strstr(esp_gps->item_str, "GLL")) {
      esp_gps->cur_statement = STATEMENT_GLL;
    }
#endif
#if CONFIG_NMEA_STATEMENT_VTG
    else if (strstr(esp_gps->item_str, "VTG")) {
      esp_gps->cur_statement = STATEMENT_VTG;
    }
#endif
    else if (strstr(esp_gps->item_str, "ZDA")) {
      esp_gps->cur_statement = STATEMENT_ZDA;
    } else {
      esp_gps->cur_statement = STATEMENT_UNKNOWN;
    }
    goto out;
  }
  /* Parse each item, depend on the type of the statement */
  if (esp_gps->cur_statement == STATEMENT_UNKNOWN) {
    goto out;
  }
#if CONFIG_NMEA_STATEMENT_GGA
  else if (esp_gps->cur_statement == STATEMENT_GGA) {
    parse_gga(esp_gps);
  }
#endif
#if CONFIG_NMEA_STATEMENT_GSA
  else if (esp_gps->cur_statement == STATEMENT_GSA) {
    parse_gsa(esp_gps);
  }
#endif
#if CONFIG_NMEA_STATEMENT_GSV
  else if (esp_gps->cur_statement == STATEMENT_GSV) {
    parse_gsv(esp_gps);
  }
#endif
#if CONFIG_NMEA_STATEMENT_RMC
  else if (esp_gps->cur_statement == STATEMENT_RMC) {
    parse_rmc(esp_gps);
  }
#endif
#if CONFIG_NMEA_STATEMENT_GLL
  else if (esp_gps->cur_statement == STATEMENT_GLL) {
    parse_gll(esp_gps);
  }
#endif
#if CONFIG_NMEA_STATEMENT_VTG
  else if (esp_gps->cur_statement == STATEMENT_VTG) {
    parse_vtg(esp_gps);
  }
#endif
  else if (esp_gps->cur_statement == STATEMENT_ZDA) {
    parse_zda(esp_gps);
  } else {
    err = ESP_FAIL;
  }
out:
  return err;
}

/**
 * @brief Parse NMEA statements from GPS receiver
 *
 * @param esp_gps esp_gps_t type object
 * @param len number of bytes to decode
 * @return esp_err_t ESP_OK on success, ESP_FAIL on error
 */
static esp_err_t gps_decode(esp_gps_t* esp_gps, size_t len) {
  const uint8_t* d = esp_gps->buffer;
  while (*d) {
    /* Start of a statement */
    if (*d == '$') {
      /* Reset runtime information */
      esp_gps->asterisk = 0;
      esp_gps->item_num = 0;
      esp_gps->item_pos = 0;
      esp_gps->cur_statement = 0;
      esp_gps->crc = 0;
      esp_gps->sat_count = 0;
      esp_gps->sat_num = 0;
      /* Add character to item */
      if (esp_gps->item_pos < NMEA_MAX_STATEMENT_ITEM_LENGTH - 1) {
        esp_gps->item_str[esp_gps->item_pos++] = *d;
        esp_gps->item_str[esp_gps->item_pos] = '\0';
      }
    }
    /* Detect item separator character */
    else if (*d == ',') {
      /* Parse current item */
      parse_item(esp_gps);
      /* Add character to CRC computation */
      esp_gps->crc ^= (uint8_t) (*d);
      /* Start with next item */
      esp_gps->item_pos = 0;
      esp_gps->item_str[0] = '\0';
      esp_gps->item_num++;
    }
    /* End of CRC computation */
    else if (*d == '*') {
      /* Parse current item */
      parse_item(esp_gps);
      /* Asterisk detected */
      esp_gps->asterisk = 1;
      /* Start with next item */
      esp_gps->item_pos = 0;
      esp_gps->item_str[0] = '\0';
      esp_gps->item_num++;
    }
    /* End of statement */
    else if (*d == '\r') {
      /* Convert received CRC from string (hex) to number */
      uint8_t crc = (uint8_t) strtol(esp_gps->item_str, NULL, 16);
      /* CRC passed */
      if (esp_gps->crc == crc) {
        switch (esp_gps->cur_statement) {
#if CONFIG_NMEA_STATEMENT_GGA
          case STATEMENT_GGA:
            esp_gps->parsed_statement |= 1 << STATEMENT_GGA;
            break;
#endif
#if CONFIG_NMEA_STATEMENT_GSA
          case STATEMENT_GSA:
            esp_gps->parsed_statement |= 1 << STATEMENT_GSA;
            break;
#endif
#if CONFIG_NMEA_STATEMENT_RMC
          case STATEMENT_RMC:
            esp_gps->parsed_statement |= 1 << STATEMENT_RMC;
            break;
#endif
#if CONFIG_NMEA_STATEMENT_GSV
          case STATEMENT_GSV:
            if (esp_gps->sat_num == esp_gps->sat_count) {
              esp_gps->parsed_statement |= 1 << STATEMENT_GSV;
            }
            break;
#endif
#if CONFIG_NMEA_STATEMENT_GLL
          case STATEMENT_GLL:
            esp_gps->parsed_statement |= 1 << STATEMENT_GLL;
            break;
#endif
#if CONFIG_NMEA_STATEMENT_VTG
          case STATEMENT_VTG:
            esp_gps->parsed_statement |= 1 << STATEMENT_VTG;
            break;
#endif
          case STATEMENT_ZDA:
            esp_gps->parsed_statement |= 1 << STATEMENT_ZDA;
            break;
          default:
            break;
        }
        /* Check if all statements have been parsed */
        if (((esp_gps->parsed_statement) & esp_gps->all_statements) ==
            esp_gps->all_statements) {
          esp_gps->parsed_statement = 0;
          /* Call user callback to notify that GPS information has been updated
           */
          if (esp_gps->event_handler) {
            esp_gps->event_handler(esp_gps->event_handler_arg, ESP_NMEA_EVENT,
                                   GPS_UPDATE, &(esp_gps->parent));
          }
        }
      } else {
        ESP_LOGD(TAG, "CRC Error for statement:%s", esp_gps->buffer);
      }
      if (esp_gps->cur_statement == STATEMENT_UNKNOWN) {
        /* Call user callback to notify that one unknown statement has been met
         */
        if (esp_gps->event_handler) {
          esp_gps->event_handler(esp_gps->event_handler_arg, ESP_NMEA_EVENT,
                                 GPS_UNKNOWN, esp_gps->buffer);
        }
      }
    }
    /* Other non-space character */
    else {
      if (!(esp_gps->asterisk)) {
        /* Add to CRC */
        esp_gps->crc ^= (uint8_t) (*d);
      }
      /* Add character to item */
      if (esp_gps->item_pos < NMEA_MAX_STATEMENT_ITEM_LENGTH - 1) {
        esp_gps->item_str[esp_gps->item_pos++] = *d;
        esp_gps->item_str[esp_gps->item_pos] = '\0';
      }
    }
    /* Process next character */
    d++;
  }
  return ESP_OK;
}

/**
 * @brief Handle when a pattern has been detected by uart
 *
 * @param esp_gps esp_gps_t type object
 */
static void __attribute__((unused)) esp_handle_uart_pattern(
    esp_gps_t* esp_gps) {
  int pos = uart_pattern_pop_pos(esp_gps->uart_port);
  if (pos != -1) {
    if (pos >= NMEA_PARSER_RUNTIME_BUFFER_SIZE) {
      pos = NMEA_PARSER_RUNTIME_BUFFER_SIZE - 1;
    }
    /* read one line(include '\n') */
    int read_len = uart_read_bytes(esp_gps->uart_port, esp_gps->buffer, pos + 1,
                                   100 / portTICK_PERIOD_MS);
    if (read_len > 0) {
      if (read_len >= NMEA_PARSER_RUNTIME_BUFFER_SIZE) {
        read_len = NMEA_PARSER_RUNTIME_BUFFER_SIZE - 1;
      }
      /* make sure the line is a standard string */
      esp_gps->buffer[read_len] = '\0';
      /* Send new line to handle */
      if (gps_decode(esp_gps, read_len + 1) != ESP_OK) {
        ESP_LOGW(TAG, "GPS decode line failed");
      }
    }
  } else {
    ESP_LOGW(TAG, "Pattern Queue Size too small");
    uart_flush_input(esp_gps->uart_port);
  }
}

/**
 * @brief NMEA Parser Task Entry
 *
 * @param arg argument
 */
static void nmea_parser_task_entry(void* arg) {
  esp_gps_t* esp_gps = (esp_gps_t*) arg;

  ESP_LOGI(TAG, "NMEA Parser task started");
  esp_gps->is_running = true;

  while (esp_gps->is_running) {
    // Read data from UART using DMA with 50ms timeout
    int len =
        uart_read_bytes(esp_gps->uart_port, esp_gps->buffer,
                        NMEA_PARSER_RUNTIME_BUFFER_SIZE - 1, pdMS_TO_TICKS(50));

    if (esp_gps->is_running && len > 0) {
      // Null-terminate the buffer
      esp_gps->buffer[len] = '\0';

      // Parse the NMEA data
      if (esp_gps->is_running && gps_decode(esp_gps, len) != ESP_OK) {
        ESP_LOGW(TAG, "GPS decode failed");
      }
    }

    if (esp_gps->is_running) {
      vTaskDelay(pdMS_TO_TICKS(10));
    }
  }

  ESP_LOGI(TAG, "NMEA Parser task exiting gracefully");
  if (esp_gps->task_done_sem) {
    xSemaphoreGive(esp_gps->task_done_sem);
  }
  vTaskDelete(NULL);
}

/**
 * @brief Init NMEA Parser
 *
 * @param config Configuration of NMEA Parser
 * @return nmea_parser_handle_t handle of nmea_parser
 */
nmea_parser_handle_t nmea_parser_init(const nmea_parser_config_t* config) {
#if !defined(CONFIG_NMEA_PARSER_DEBUG)
  esp_log_level_set(TAG, ESP_LOG_NONE);
#endif

  esp_gps_t* esp_gps = calloc(1, sizeof(esp_gps_t));
  if (!esp_gps) {
    ESP_LOGE(TAG, "calloc memory for esp_fps failed");
    goto err_gps;
  }
  esp_gps->buffer = calloc(1, NMEA_PARSER_RUNTIME_BUFFER_SIZE);
  if (!esp_gps->buffer) {
    ESP_LOGE(TAG, "calloc memory for runtime buffer failed");
    goto err_buffer;
  }

  esp_gps->task_done_sem = xSemaphoreCreateBinary();
  if (!esp_gps->task_done_sem) {
    ESP_LOGE(TAG, "create task_done_sem failed");
    goto err_sem;
  }

#if CONFIG_NMEA_STATEMENT_GSA
  esp_gps->all_statements |= (1 << STATEMENT_GSA);
#endif
#if CONFIG_NMEA_STATEMENT_GSV
  esp_gps->all_statements |= (1 << STATEMENT_GSV);
#endif
#if CONFIG_NMEA_STATEMENT_GGA
  esp_gps->all_statements |= (1 << STATEMENT_GGA);
#endif
#if CONFIG_NMEA_STATEMENT_RMC
  esp_gps->all_statements |= (1 << STATEMENT_RMC);
#endif
#if CONFIG_NMEA_STATEMENT_GLL
  esp_gps->all_statements |= (1 << STATEMENT_GLL);
#endif
#if CONFIG_NMEA_STATEMENT_VTG
  esp_gps->all_statements |= (1 << STATEMENT_VTG);
#endif

  /* Set attributes */
  esp_gps->uart_port = config->uart.uart_port;
  esp_gps->all_statements &= 0xFE;

  /* Initialize event handler callbacks to NULL */
  esp_gps->event_handler = NULL;
  esp_gps->event_handler_arg = NULL;

  /* Install UART driver */
  uart_config_t uart_config = {
      .baud_rate = config->uart.baud_rate,
      .data_bits = config->uart.data_bits,
      .parity = config->uart.parity,
      .stop_bits = config->uart.stop_bits,
      .flow_ctrl = UART_HW_FLOWCTRL_DISABLE,
      .source_clk = UART_SCLK_DEFAULT,
  };

  if (uart_param_config(esp_gps->uart_port, &uart_config) != ESP_OK) {
    ESP_LOGE(TAG, "config uart parameter failed");
    goto err_uart_config;
  }
  if (uart_set_pin(esp_gps->uart_port, CONFIG_NMEA_PARSER_UART_TXD,
                   config->uart.rx_pin, UART_PIN_NO_CHANGE,
                   UART_PIN_NO_CHANGE) != ESP_OK) {
    ESP_LOGE(TAG, "config uart gpio failed");
    goto err_uart_config;
  }

  if (uart_driver_install(
          esp_gps->uart_port, CONFIG_NMEA_PARSER_RING_BUFFER_SIZE,
          CONFIG_NMEA_PARSER_RING_BUFFER_SIZE, 0, NULL, 0) != ESP_OK) {
    ESP_LOGE(TAG, "install uart driver failed");
    goto err_uart_install;
  }

  /* Create NMEA Parser task - will use UART DMA mode */
  esp_err_t err = task_manager_create(
      nmea_parser_task_entry, "nmea_parser",
      TASK_STACK_LARGE,  // 8KB (CONFIG_NMEA_PARSER_TASK_STACK_SIZE)
      esp_gps,
      TASK_PRIORITY_HIGH,  // GPS es time-sensitive
      &esp_gps->tsk_hdl);

  if (err != ESP_OK) {
    ESP_LOGE(TAG, "create NMEA Parser task failed");
    goto err_task_create;
  }
  ESP_LOGI(TAG, "NMEA Parser init OK");
  return esp_gps;

  /*Error Handling*/
err_task_create:
  uart_driver_delete(esp_gps->uart_port);
err_uart_install:
err_uart_config:
  vSemaphoreDelete(esp_gps->task_done_sem);
err_sem:
  free(esp_gps->buffer);
err_buffer:
  free(esp_gps);
err_gps:
  return NULL;
}

/**
 * @brief Deinit NMEA Parser
 *
 * @param nmea_hdl handle of NMEA parser
 * @return esp_err_t ESP_OK on success,ESP_FAIL on error
 */
esp_err_t nmea_parser_deinit(nmea_parser_handle_t nmea_hdl) {
  esp_gps_t* esp_gps = (esp_gps_t*) nmea_hdl;
  if (!esp_gps) {
    return ESP_ERR_INVALID_ARG;
  }

  // 1. Unregister event handler so no further callbacks fire
  esp_gps->event_handler = NULL;
  esp_gps->event_handler_arg = NULL;

  // 2. Signal task to stop running
  esp_gps->is_running = false;

  // 3. Wait up to 250ms for task to exit cleanly and release any mutexes
  if (esp_gps->task_done_sem) {
    if (xSemaphoreTake(esp_gps->task_done_sem, pdMS_TO_TICKS(250)) != pdTRUE) {
      ESP_LOGW(TAG, "NMEA Parser task did not stop in time, forcing delete");
      if (esp_gps->tsk_hdl) {
        task_manager_delete(esp_gps->tsk_hdl);
      }
    }
    vSemaphoreDelete(esp_gps->task_done_sem);
    esp_gps->task_done_sem = NULL;
  } else if (esp_gps->tsk_hdl) {
    task_manager_delete(esp_gps->tsk_hdl);
  }

  // 4. Delete UART driver
  esp_err_t err = uart_driver_delete(esp_gps->uart_port);

  // 5. Free allocated memory
  if (esp_gps->buffer) {
    free(esp_gps->buffer);
    esp_gps->buffer = NULL;
  }
  free(esp_gps);

  return err;
}

/**
 * @brief Add user defined handler for NMEA parser
 *
 * @param nmea_hdl handle of NMEA parser
 * @param event_handler user defined event handler
 * @param handler_args handler specific arguments
 * @return esp_err_t
 *  - ESP_OK: Success
 *  - ESP_ERR_INVALID_ARG: Invalid arguments
 */
esp_err_t nmea_parser_add_handler(nmea_parser_handle_t nmea_hdl,
                                  esp_event_handler_t event_handler,
                                  void* handler_args) {
  esp_gps_t* esp_gps = (esp_gps_t*) nmea_hdl;

  if (!esp_gps || !event_handler) {
    return ESP_ERR_INVALID_ARG;
  }

  // Store the callback and its argument
  esp_gps->event_handler = event_handler;
  esp_gps->event_handler_arg = handler_args;

  ESP_LOGI(TAG, "Event handler registered");
  return ESP_OK;
}

/**
 * @brief Remove user defined handler for NMEA parser
 *
 * @param nmea_hdl handle of NMEA parser
 * @param event_handler user defined event handler (unused, kept for API
 * compatibility)
 * @return esp_err_t
 *  - ESP_OK: Success
 *  - ESP_ERR_INVALID_ARG: Invalid arguments
 */
esp_err_t nmea_parser_remove_handler(nmea_parser_handle_t nmea_hdl,
                                     esp_event_handler_t event_handler) {
  esp_gps_t* esp_gps = (esp_gps_t*) nmea_hdl;

  if (!esp_gps) {
    return ESP_ERR_INVALID_ARG;
  }

  // Clear the callback
  esp_gps->event_handler = NULL;
  esp_gps->event_handler_arg = NULL;

  ESP_LOGI(TAG, "Event handler unregistered");
  return ESP_OK;
}
