ElectronicCats/Minino/firmware/components/sd_card/sd_card.c

#include "sd_card.h"

#include <dirent.h>
#include <errno.h>
#include <string.h>
#include <sys/stat.h>
#include <sys/types.h>
#include <unistd.h>
#include "driver/sdmmc_host.h"
#include "driver/sdspi_host.h"
#include "driver/spi_common.h"
#include "esp_err.h"
#include "esp_log.h"
#include "esp_vfs_fat.h"
#include "ff.h"
#include "freertos/FreeRTOS.h"
#include "sdmmc_cmd.h"

#define MOUNT_POINT   "/sdcard"
#define MAX_CHAR_SIZE 1024
#define PIN_NUM_MISO  20
#define PIN_NUM_MOSI  19
#define PIN_NUM_CLK   21
#define PIN_NUM_CS    18

const char* f_result_to_name[] = {"FR_OK",
                                  "FR_DISK_ERR",
                                  "FR_INT_ERR",
                                  "FR_NOT_READY",
                                  "FR_NO_FILE",
                                  "FR_NO_PATH",
                                  "FR_INVALID_NAME",
                                  "FR_DENIED",
                                  "FR_EXIST",
                                  "FR_INVALID_OBJECT",
                                  "FR_WRITE_PROTECTED",
                                  "FR_INVALID_DRIVE",
                                  "FR_NOT_ENABLED",
                                  "FR_NO_FILESYSTEM",
                                  "FR_MKFS_ABORTED",
                                  "FR_TIMEOUT",
                                  "FR_LOCKED",
                                  "FR_NOT_ENOUGH_CORE",
                                  "FR_TOO_MANY_OPEN_FILES",
                                  "FR_INVALID_PARAMETER"};

#include "freertos/semphr.h"

static const char* TAG = "sd_card";
sdmmc_card_t* card = NULL;
bool _format_if_mount_failed = false;
sd_card_info_t _sd_card_info;
static bool s_sd_card_mounted = false;
static SemaphoreHandle_t s_sd_mutex = NULL;

static void sd_card_lock() {
  if (s_sd_mutex == NULL) {
    s_sd_mutex = xSemaphoreCreateMutex();
  }
  if (s_sd_mutex != NULL) {
    xSemaphoreTake(s_sd_mutex, portMAX_DELAY);
  }
}

static void sd_card_unlock() {
  if (s_sd_mutex != NULL) {
    xSemaphoreGive(s_sd_mutex);
  }
}

esp_err_t sd_card_fill_info(const sdmmc_card_t* card);

void print_files_in_sd() {
  if (sd_card_is_not_mounted()) {
    ESP_LOGE(TAG, "SD card not mounted");
    return;
  }

  DIR* dir;
  struct dirent* ent;
  if ((dir = opendir(MOUNT_POINT)) != NULL) {
    while ((ent = readdir(dir)) != NULL) {
      ESP_LOGI(TAG, "%s", ent->d_name);
    }
    closedir(dir);
  } else {
    ESP_LOGE(TAG, "Could not open directory");
    return;
  }
}

/** 'mount' command */
int mount() {
  esp_err_t ret;
  /* mount sd card */
  ESP_LOGI(TAG, "Initializing SD card, format: %s",
           _format_if_mount_failed ? "true" : "false");
  esp_vfs_fat_sdmmc_mount_config_t mount_config = {
      .format_if_mount_failed = _format_if_mount_failed,
      .max_files = 4,
      .allocation_unit_size = 16 * 1024};

  // initialize SD card and mount FAT filesystem.
  ESP_LOGI(TAG, "Using SPI peripheral");
  sdmmc_host_t host = SDSPI_HOST_DEFAULT();
  spi_bus_config_t bus_cfg = {
      .mosi_io_num = PIN_NUM_MOSI,
      .miso_io_num = PIN_NUM_MISO,
      .sclk_io_num = PIN_NUM_CLK,
      .quadwp_io_num = -1,
      .quadhd_io_num = -1,
      .max_transfer_sz = 4000,
  };
  ret = spi_bus_initialize(host.slot, &bus_cfg, SPI_DMA_CH_AUTO);
  if (ret != ESP_OK && ret != ESP_ERR_INVALID_STATE) {
    ESP_LOGE(TAG, "Failed to initialize bus: %s", esp_err_to_name(ret));
    return ESP_ERR_NO_MEM;
  }

  // This initializes the slot without card detect (CD) and write protect (WP)
  // signals. Modify slot_config.gpio_cd and slot_config.gpio_wp if your board
  // has these signals.
  sdspi_device_config_t slot_config = SDSPI_DEVICE_CONFIG_DEFAULT();
  slot_config.gpio_cs = PIN_NUM_CS;
  slot_config.host_id = host.slot;

  ret = esp_vfs_fat_sdspi_mount(MOUNT_POINT, &host, &slot_config, &mount_config,
                                &card);

  if (ret != ESP_OK) {
    if (ret == ESP_FAIL) {
      ESP_LOGE(TAG,
               "Failed to mount filesystem. "
               "If you want the card to be formatted, set "
               "format_if_mount_failed = true.");
      return ESP_ERR_NOT_SUPPORTED;
    } else {
      ESP_LOGE(TAG,
               "Failed to initialize the card (%s). "
               "Make sure SD card lines have pull-up resistors in place.",
               esp_err_to_name(ret));
      return ESP_ERR_NOT_FOUND;
    }
  }
  /* print card info if mount successfully */
  // sdmmc_card_print_info(stdout, card);
  sd_card_fill_info(card);
  s_sd_card_mounted = true;
  return ESP_OK;
}

esp_err_t unmount() {
  if (sd_card_is_not_mounted()) {
    ESP_LOGE(TAG, "SD card not mounted");
    return ESP_ERR_NOT_ALLOWED;
  }

  /* unmount sd card */
  if (esp_vfs_fat_sdcard_unmount(MOUNT_POINT, card) != ESP_OK) {
    ESP_LOGE(TAG, "Card unmount failed");
    return ESP_FAIL;
  }
  card = NULL;
  s_sd_card_mounted = false;

  ESP_LOGI(TAG, "Card unmounted");
  return ESP_OK;
}

void sd_card_begin() {
  if (s_sd_mutex == NULL) {
    s_sd_mutex = xSemaphoreCreateMutex();
  }
#if !defined(CONFIG_SD_CARD_DEBUG)
  esp_log_level_set(TAG, ESP_LOG_NONE);
#endif
}

esp_err_t sd_card_mount() {
#ifndef CONFIG_SD_ENABLED
  return ESP_ERR_NOT_SUPPORTED;
#endif
  ESP_LOGI(TAG, "Mounting SD Card...");
  esp_err_t err = ESP_OK;
  if (sd_card_is_mounted()) {
    ESP_LOGW(TAG, "SD card already mounted");
    return err;
  }

  err = mount();
  if (err != ESP_OK) {
    ESP_LOGE(TAG, "Failed to mount SD card: %s", esp_err_to_name(err));
    return err;
  }

  return ESP_OK;
}

esp_err_t sd_card_unmount() {
  if (sd_card_is_not_mounted()) {
    ESP_LOGW(TAG, "SD card not mounted");
    return ESP_OK;
  }

  return unmount();
}

esp_err_t sd_card_check_format() {
  ESP_LOGI(TAG, "Checking SD Card format...");
  _format_if_mount_failed = true;
  esp_err_t err = sd_card_mount();
  _format_if_mount_failed = false;
  return err;
}

esp_err_t sd_card_format() {
  esp_err_t err = ESP_OK;
  if (sd_card_is_not_mounted()) {
    err = sd_card_mount();
  }

  if (err != ESP_OK) {
    ESP_LOGE(TAG, "Failed to mount SD card");
    return ESP_FAIL;
  }

  ESP_LOGI(TAG, "Formatting SD Card...");
  err = esp_vfs_fat_sdcard_format(MOUNT_POINT, card);
  if (err != ESP_OK) {
    ESP_LOGE(TAG, "Failed to format SD card");
    return ESP_FAIL;
  }

  return ESP_OK;
  // return err;
}

bool sd_card_is_mounted() {
  return s_sd_card_mounted && (card != NULL);
}

bool sd_card_is_not_mounted() {
  return !sd_card_is_mounted();
}

static void sd_card_build_full_path(const char* path,
                                    char* full_path,
                                    size_t max_len) {
  if (path == NULL || full_path == NULL || max_len == 0) {
    return;
  }
  // Sanitize path against directory traversal
  if (strstr(path, "..") != NULL || strchr(path, '\\') != NULL) {
    full_path[0] = '\0';
    return;
  }
  if (strncmp(path, MOUNT_POINT, strlen(MOUNT_POINT)) == 0) {
    snprintf(full_path, max_len, "%s", path);
  } else if (path[0] == '/') {
    snprintf(full_path, max_len, "%s%s", MOUNT_POINT, path);
  } else {
    snprintf(full_path, max_len, "%s/%s", MOUNT_POINT, path);
  }
}

esp_err_t sd_card_create_dir(const char* dir_name) {
  if (sd_card_is_not_mounted()) {
    ESP_LOGE(TAG, "SD card not mounted");
    return ESP_FAIL;
  }

  if (dir_name == NULL) {
    return ESP_ERR_INVALID_ARG;
  }

  char full_path[256];
  sd_card_build_full_path(dir_name, full_path, sizeof(full_path));

  struct stat st;
  if (stat(full_path, &st) == 0) {
    if (S_ISDIR(st.st_mode)) {
      return ESP_OK;
    }
  }

  sd_card_lock();
  int res = mkdir(full_path, 0777);
  sd_card_unlock();

  if (res == 0 || errno == EEXIST) {
    ESP_LOGI(TAG, "Directory ready: %s", full_path);
    return ESP_OK;
  } else {
    ESP_LOGE(TAG, "Failed to create directory %s: %s", full_path,
             strerror(errno));
    return ESP_FAIL;
  }
}

esp_err_t sd_card_list_files(const char* path) {
  ESP_LOGE(TAG, "Reading list files");
  FF_DIR dp;
  FRESULT res = f_opendir(&dp, path);
  if (res != FR_OK) {
    ESP_LOGE(TAG, "Cant open dir");
    return ESP_FAIL;
  }
  f_closedir(&dp);
  return ESP_OK;
}

esp_err_t sd_card_create_file(const char* path) {
  if (sd_card_is_not_mounted()) {
    ESP_LOGE(TAG, "SD card not mounted");
    return ESP_FAIL;
  }

  if (path == NULL) {
    ESP_LOGE(TAG, "Path is NULL");
    return ESP_ERR_INVALID_ARG;
  }

  char full_path[256];
  sd_card_build_full_path(path, full_path, sizeof(full_path));

  sd_card_lock();
  // Try to read it to check if it exists
  FILE* file = fopen(full_path, "r");
  if (file != NULL) {
    ESP_LOGE(TAG, "File already exists");
    fclose(file);
    sd_card_unlock();
    return ESP_ERR_FILE_EXISTS;
  }

  file = fopen(full_path, "w");
  if (file == NULL) {
    ESP_LOGE(TAG, "Failed to open file for writing");
    sd_card_unlock();
    return ESP_FAIL;
  }

  fclose(file);
  sd_card_unlock();
  return ESP_OK;
}

esp_err_t sd_card_read_file(const char* path) {
  if (sd_card_is_not_mounted()) {
    ESP_LOGE(TAG, "SD card not mounted");
    return ESP_FAIL;
  }

  if (path == NULL) {
    ESP_LOGE(TAG, "Path is NULL");
    return ESP_FAIL;
  }

  char full_path[256];
  sd_card_build_full_path(path, full_path, sizeof(full_path));

  sd_card_lock();
  ESP_LOGI(TAG, "Reading file %s", full_path);
  FILE* file = fopen(full_path, "r");
  if (file == NULL) {
    ESP_LOGE(TAG, "Failed to open file for reading");
    sd_card_unlock();
    return ESP_FAIL;
  }

  char line[MAX_CHAR_SIZE];
  ESP_LOGI(TAG, "Read from file:");
  while (fgets(line, sizeof(line), file) != NULL) {
    // strip newline
    char* pos = strchr(line, '\n');
    if (pos) {
      *pos = '\0';
    }
    ESP_LOGI(TAG, "'%s'", line);
  }
  fclose(file);
  sd_card_unlock();

  return ESP_OK;
}

esp_err_t sd_card_write_file(const char* path, char* data) {
  if (sd_card_is_not_mounted()) {
    ESP_LOGE(TAG, "SD card not mounted");
    return ESP_FAIL;
  }

  if (path == NULL || data == NULL) {
    ESP_LOGE(TAG, "Invalid argument: path or data is NULL");
    return ESP_ERR_INVALID_ARG;
  }

  char full_path[256];
  sd_card_build_full_path(path, full_path, sizeof(full_path));

  sd_card_lock();
  ESP_LOGI(TAG, "Opening file w %s", full_path);
  FILE* file = fopen(full_path, "w");
  if (file == NULL) {
    ESP_LOGE(TAG, "Failed to open file for writing");
    sd_card_unlock();
    return ESP_FAIL;
  }
  fputs(data, file);
  fclose(file);
  sd_card_unlock();
  ESP_LOGI(TAG, "File written");

  return ESP_OK;
}

esp_err_t sd_card_append_to_file(const char* path, char* data) {
  if (sd_card_is_not_mounted()) {
    ESP_LOGE(TAG, "SD card not mounted");
    return ESP_FAIL;
  }

  if (path == NULL || data == NULL) {
    ESP_LOGE(TAG, "Invalid argument: path or data is NULL");
    return ESP_ERR_INVALID_ARG;
  }

  char full_path[256];
  sd_card_build_full_path(path, full_path, sizeof(full_path));

  sd_card_lock();
  ESP_LOGI(TAG, "Opening file a %s", full_path);
  FILE* file = fopen(full_path, "a");
  if (file == NULL) {
    ESP_LOGE(TAG, "Failed to open file for writing");
    sd_card_unlock();
    return ESP_FAIL;
  }
  size_t data_len = strlen(data);
  size_t written = fwrite(data, 1, data_len, file);
  if (written != data_len) {
    ESP_LOGE(TAG, "Failed to write all data to file: wrote %d of %d bytes",
             (int) written, (int) data_len);
    fclose(file);
    sd_card_unlock();
    return ESP_FAIL;
  }
  if (fflush(file) != 0) {
    ESP_LOGE(TAG, "Failed to flush file");
    fclose(file);
    sd_card_unlock();
    return ESP_FAIL;
  }
  fclose(file);
  sd_card_unlock();
  ESP_LOGI(TAG, "File written");

  return ESP_OK;
}

size_t sd_card_get_file_size(FILE* file) {
  if (file == NULL) {
    return 0;
  }
  long current_ptr = ftell(file);
  fseek(file, 0, SEEK_END);
  size_t file_size = ftell(file);
  fseek(file, current_ptr, SEEK_SET);
  return file_size;
}

esp_err_t sd_card_fill_info(const sdmmc_card_t* card) {
  if (card == NULL) {
    ESP_LOGE(TAG, "Card is NULL");
    return ESP_FAIL;
  }

  _sd_card_info.name = card->cid.name;
  _sd_card_info.total_space =
      ((uint64_t) card->csd.capacity) * card->csd.sector_size / (1024 * 1024);
  _sd_card_info.speed = card->real_freq_khz < 1000
                            ? card->real_freq_khz
                            : card->real_freq_khz / 1000.0;
  if (card->is_sdio) {
    _sd_card_info.type = "SDIO";
  } else if (card->is_mmc) {
    _sd_card_info.type = "MMC";
  } else {
    int SD_OCR_SDHC_CAP = 1 << 30;
    _sd_card_info.type = (card->ocr & SD_OCR_SDHC_CAP) ? "SDHC/SDXC" : "SDSC";
  }
  return ESP_OK;
}

sd_card_info_t sd_card_get_info() {
  return _sd_card_info;
}
