ElectronicCats/Minino/firmware/components/console/esp_console_repl_chip.c

/*
 * SPDX-FileCopyrightText: 2016-2024 Espressif Systems (Shanghai) CO LTD
 *
 * SPDX-License-Identifier: Apache-2.0
 */

#include <fcntl.h>
#include <stdint.h>
#include <stdio.h>
#include <sys/cdefs.h>
#include "driver/uart.h"
#include "driver/uart_vfs.h"
#include "driver/usb_serial_jtag.h"
#include "driver/usb_serial_jtag_vfs.h"
#include "esp_console.h"
#include "esp_err.h"
#include "esp_log.h"
#include "esp_vfs_cdcacm.h"
#include "freertos/FreeRTOS.h"
#include "freertos/task.h"
#include "sdkconfig.h"

#include "console_private.h"

#if !CONFIG_ESP_CONSOLE_NONE
static const char* TAG = "console.repl";
#endif  // !CONFIG_ESP_CONSOLE_NONE

#if CONFIG_ESP_CONSOLE_UART_DEFAULT || CONFIG_ESP_CONSOLE_UART_CUSTOM
static esp_err_t esp_console_repl_uart_delete(esp_console_repl_t* repl);
#endif  // CONFIG_ESP_CONSOLE_UART_DEFAULT || CONFIG_ESP_CONSOLE_UART_CUSTOM
#if CONFIG_ESP_CONSOLE_USB_CDC
static esp_err_t esp_console_repl_usb_cdc_delete(esp_console_repl_t* repl);
#endif  // CONFIG_ESP_CONSOLE_USB_CDC
#if CONFIG_ESP_CONSOLE_USB_SERIAL_JTAG
static esp_err_t esp_console_repl_usb_serial_jtag_delete(
    esp_console_repl_t* repl);
#endif  // CONFIG_ESP_CONSOLE_USB_SERIAL_JTAG

#if CONFIG_ESP_CONSOLE_USB_CDC
esp_err_t esp_console_new_repl_usb_cdc(
    const esp_console_dev_usb_cdc_config_t* dev_config,
    const esp_console_repl_config_t* repl_config,
    esp_console_repl_t** ret_repl) {
  esp_err_t ret = ESP_OK;
  esp_console_repl_universal_t* cdc_repl = NULL;
  if (!repl_config || !dev_config || !ret_repl) {
    ret = ESP_ERR_INVALID_ARG;
    goto _exit;
  }
  // allocate memory for console REPL context
  cdc_repl = calloc(1, sizeof(esp_console_repl_universal_t));
  if (!cdc_repl) {
    ret = ESP_ERR_NO_MEM;
    goto _exit;
  }

  /* Minicom, screen, idf_monitor send CR when ENTER key is pressed */
  esp_vfs_dev_cdcacm_set_rx_line_endings(ESP_LINE_ENDINGS_CR);
  /* Move the caret to the beginning of the next line on '\n' */
  esp_vfs_dev_cdcacm_set_tx_line_endings(ESP_LINE_ENDINGS_CRLF);
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
