ElectronicCats/Minino/(commit log)

2022-11-29 init Schematic
    [minino.kicad_pcb, minino.kicad_sch, minino.sch]
2022-11-29 select ESP32S3
    [minino.kicad_sch]
2022-12-05 Assigned pins in the schematic
    [minino.kicad_sch]
2023-01-14 update usb
    [minino.kicad_pcb]
2023-03-02 Update example spoof for ESP32-S3
2023-03-08 Change_ button
    [minino.kicad_pcb, minino.kicad_sch]
2023-05-23 feat: add the left and select buttons
2023-05-23 feat: add a directional buttons class
2023-05-23 test: print the pressed buttons in the main loop
2023-05-23 refactor: replace digital read of buttons by the keyboard implementation
2023-05-24 refactor: leds code
2023-05-25 feat: display scanned devices
2023-05-25 feat: hold the detected air tag until the right button is pressed
2023-05-25 fix: improve back to main menu speed and reliability by pressing the left button
2023-05-31 feat: draw a frame for the lists
2023-06-07 change lcsc part "C2886897" to "C318889"
    [minino.kicad_sch]
2024-01-22 add microSD
    [minino.kicad_sch]
2024-01-30 SDA/SCL Replaced and Center button eliminated
    [minino.kicad_pcb, minino.kicad_sch]
2024-01-30 Size Updated
    [minino.kicad_pcb, minino.kicad_sch]
2024-01-31 GPS Added
    [minino.kicad_pcb, minino.kicad_sch]
2024-02-01 Uart header placed
    [minino.kicad_pcb, minino.kicad_sch]
2024-02-01 I2C header added
    [minino.kicad_pcb, minino.kicad_sch]
2024-02-01 Antenna shielded
    [minino.kicad_pcb, minino.kicad_sch]
2024-02-28 feat: add buttons callback
2024-02-28 feat: show pressed button on display
2024-03-04 fix: Buzzer part BOM - GPS RxTx & BAT pins swapped
    [minino.kicad_pcb, minino.kicad_sch]
2024-03-05 fix: replace sh1107 with sh1106 driver
    [main.c]
2024-03-05 fix: invert left and right button pins
    [main.c]
2024-03-05 fix: display BOM modified
    [minino.kicad_sch]
2024-03-11 feat: add buzzer sound at startup
    [buzzer.c, buzzer.h, main.c]
2024-03-12 feat: add open thread cli
    [partitions.csv]
2024-03-12 feat: add thread cli instructions
2024-03-13 feat: enable thread cli with button
2024-03-14 feat: add bluetooth scanner
    [partitions.csv]
2024-03-20 fix: soft buzzer sound
    [buzzer.c, main.c]
2024-03-20 feat(hw):add logo pwnlabs and EC and Kicad 8
    [minino.kicad_pcb]
2024-03-20 feat: blink leds at startup
2024-04-04 feat: add wifi sniffer cli
    [partitions.csv]
2024-04-04 feat: deactivate thread cli
    [partitions.csv]
2024-04-08 feat: esp32 & led resistors & version UPDATED
    [minino.kicad_pcb, minino.kicad_sch]
2024-04-17 fix: Adding SD card unmount
    [sd_card.c]
2024-04-18 feat: add zigbee switch coordinator
    [partitions.csv]
2024-04-19 feat: zigbee switch toggle from ui
2024-04-19 feat: remove switch driver
2024-04-19 feat: add zigbee switch toggle animation
2024-04-23 refactor: button events
2024-04-25 feat: add zigbee factory reset
    [main.c]
2024-04-30 feat: skip logo after factory reset
    [main.c]
2024-05-06 feat: add wait for devices animation task
2024-05-06 refactor: switch state
2024-05-07 feat: add no devices found screen
2024-05-07 fix: default gps rx pin
2024-05-08 refactor: oled driver
2024-05-09 refactor: oled driver to oled screen
2024-05-09 refactor: sh1106 to oled driver
2024-05-10 refactor: move oled driver to drivers
2024-05-10 feat: print network information in sniffer summary
2024-05-11 feat: print channel
2024-05-15 feat: add wifi attacks
    [partitions.csv]
2024-05-16 refactor: update current menu
2024-05-17 feat: openthread & ieee802154 as external components (openthread working)
    [partitions.csv]
2024-05-17 feat: thread initialized from GUI
2024-05-20 feat: thread displays new broadcast messages & thread app as module
2024-05-22 feat: zigbee sniffer integrated (keyboard bug)
    [partitions.csv]
2024-05-24 feat: Trakers scanner & Spam BLE apps integrated
    bug when pressing the right button in trakers scanner App
    [partitions.csv]
2024-05-27 feat: Add led_controller component
2024-05-27 feat: led functions updated
2024-05-28 refactor: led events RGB led to simple led
2024-05-29 refactor: Bluetooth Scanner replaced
    [main.c, oled_screen.c]
2024-05-29 fix: display null text
    [oled_screen.c]
2024-05-29 feat: zigbee switch status displayed by callbacks
2024-05-31 feat: Zigbee switch working--Zigbee sniffer not working
    [ieee_sniffer.c]
2024-05-31 feat: zigbee switch & zigbee sniffer working
2024-05-31 feat: zigbee switch application as a component
2024-06-10 fix: oled display center avoid null pointers
    [oled_screen.c]
2024-06-11 fix(hw): update DNP components
    [minino.kicad_sch]
2024-06-11 feat: template for thread module
2024-06-14 feat(hw): resistor to IO8 added
    [minino.kicad_pcb, minino.kicad_sch]
2024-06-14 fix(hw): wrong name of label in schematic changed
    [minino.kicad_pcb, minino.kicad_sch]
2024-06-14 chore: remove arduino examples
    [partitions.csv]
2024-06-17 feat: saving current menu in flash when closing bt apps
2024-06-18 feat: Fuse footprint got changed & BOM updated
    [minino.kicad_sch]
2024-06-18 feat: new footprint of microSD connector added
    [ST-TF-003A.step, minino.csv]
2024-06-19 feat(hw): Micro SD connector got changed
    [minino.kicad_pcb, minino.kicad_sch]
2024-06-19 feat(hw): SD connector component changed
    [minino.kicad_sch]
2024-06-19 feat(hw): SD connector routes updated
    [minino.kicad_pcb]
2024-06-24 feat(hw): Bom updated
    [minino.csv, minino.kicad_pcb, minino.kicad_sch]
2024-06-24 feat(hw): Update GPS antenna position
    [minino.kicad_pcb, minino.kicad_sch]
2024-06-25 feat(hw): update labels
    [minino.kicad_pcb]
2024-06-25 fix(hw): a user comment was visible
    [minino.kicad_pcb]
2024-07-11 feat: Add OTA (test)
    [partitions.csv]
2024-07-12 feat: add leds effect in wifi sniffer
2024-07-15 fix: led control start & stop on thread
2024-07-15 feat: add thread broadcast code
2024-07-16 feat: Add Zigbee wireshark
2024-07-16 feat: Add DOS
    - Save WIFI AP list
    [partitions.csv]
2024-07-16 feat: Menu Configuration
    [configuration.h]
2024-07-17 fix: thread changed to NO HOST CONNECTION
2024-07-17 fix: set correct wifi sniffer channel
    [main.c]
2024-07-18 feat: Add delay buzzer
    [keyboard_module.c, main.c]
2024-07-19 feat: web file browser TEST
    [partitions.csv]
2024-07-19 refactor: switch to minino face logo
2024-07-19 refactor: web file browser http server UI improved
    [partitions.csv]
2024-07-20 fix: esp_err_already_mounted not handled
    [sd_card.c, sd_card.h]
2024-07-22 feat: add init wifi sta
    [partitions.csv]
2024-07-23 feat: add partitions_no_ota.csv
    [partitions_no_ota.csv]
2024-07-23 feat: thread sniffer
    [partitions.csv]
2024-07-24 fix: thread module exit cb
2024-07-24 feat: timer functions for animations
    [partitions.csv]
2024-07-24 refactor: analizer animation runing by a timer
2024-07-25 feat: add queue in thread sniffer
2024-07-25 !Auto stash before merge of "analyzer" and "origin/animations_based_on_timers"
    - Refactor Deauth
    - Change Logo
    - Refactor callback buttons
2024-07-25 feat: visual feed in sniffer thread
2024-07-26 feat: thread sniffer shows fatal errors
    [partitions.csv]
2024-07-27 feat: save thread pcap files into flash
    [partitions.csv]
2024-07-27 fix: display text center x offset
    [oled_screen.c]
2024-07-29 feat: thread pcaps in folders & browser div files & dirs
2024-07-30 feat: Add Led animation
2024-07-30 feat: PCAPs saved after unexpected shutdowns THREAD
2024-07-31 feat: Logo & timer section
    - User logo selection
    - Select time for screensaver
    - Add EC and PWNLabs to logos
2024-07-31 fix: keyboard navigation events
    [keyboard_module.c]
2024-07-31 fix: avoid screen saver on analizer
    [keyboard_module.c]
2024-07-31 feat: idle timer reset function in keyboard module
    [keyboard_module.c, keyboard_module.h]
2024-07-31 feat: Add reset timer
2024-07-31 fix: avoid screen saver in gps menus
    [keyboard_module.c]
2024-08-01 feat: Led off deauth
2024-08-01 feat: Folder change
    [partitions.csv, partitions_no_ota.csv]
2024-08-06 feat: renaming files
    [partitions.csv]
2024-08-08 feat: Show when mounting flash file system
2024-08-12 feat: ble hid device emulation example
2024-08-15 feat: add software reset functions
    [keyboard_module.c, keyboard_module.h]
2024-08-18 refactor: thread apps working over new menus system
2024-08-21 feat: Fix Screen Sizes trackers
    - Start zigbee refactor
    [keyboard_module.c, keyboard_module.h, oled_driver.c]
2024-08-22 fix: turn off leds after deauth scan
2024-08-22 fix: turn off leds after captive portal attack
2024-08-22 fix: avoid screen saver in general screens
    [keyboard_module.c, keyboard_module.h]
2024-08-29 feat: Add build type
    [partitions_no_ota.csv]
2024-08-29 fix: thread broadcast sender & reciever functions
2024-08-29 fix: remove unused include
    [oled_screen.c]
2024-08-29 feat: waiting devices refresh improved on zigbee switch
2024-08-29 feat: file manager refresh improved & scrolling card information fixed
    [oled_screen.c]
2024-08-29 feat: thread broadcast screen refresh improved
2024-08-30 Revert "Merge branch 'prerelease'"
    This reverts commit e5d057f79ce1e100371070e61efcf77c3153a4ba, reversing
    changes made to 6dc6df0abbe6ac32f33cfa4b0c0488f5a7a5b54b.
    [partitions.csv, partitions_no_ota.csv]
2024-08-30 feat: Fix merge
    [partitions.csv, partitions_no_ota.csv]
2024-09-20 refactor: thread sniffer screens port
2024-09-23 feat: add zigbee switch for 128x32
2024-09-23 feat: directive to enable/disable the leds component
2024-09-23 feat: directive to enable/disable the buzzer component
    [buzzer.c, leds.c]
2024-10-04 refactor: mount sd card system
2024-10-04 fix: sd card info panics when there's no sd card
    [sd_card.c]
2024-10-25 feat: Add Packet BLE
    - Fail CRC
    [uart_sender.c, uart_sender.h]
2024-10-25 feat: Fix button handler advs
2024-12-04 feat: Fix wardriving AP scanner
    [sd_card.c]
2024-12-05 feat: i2c scanner
2024-12-06 refactor: i2c menu updated
2024-12-10 feat: show minino screen address on i2c Scanner
2024-12-16 test: send data via uart0
2024-12-16 feat: print button event
2024-12-16 feat: add uart bridge component
2024-12-17 feat: add command to print over uart0
2024-12-17 feat: add command to read messages over UART0
2024-12-18 feat: add examples to uart bridge commands
2024-12-18 feat: reset screen buffer at wake up
    [oled_driver.c, oled_screen.c, sleep_mode.c]
2024-12-19 feat: add config to disable logs for uart bridge component
2024-12-19 feat: add config to disable logs for cmd uart bridge module
2024-12-20 feat: pin GPS ON/OFF and DNP R2
    [minino.kicad_sch]
2024-12-20 feat: change label F1
    [minino.kicad_sch]
2024-12-20 fix: avoid boundary refresh on clamped scrolling text
2024-12-20 feat: replace get_messages by uart_bridge cmd
2024-12-20 feat: add commands to get and set uart config
2024-12-23 fix: take afk timeout from flash on startup
    [sleep_mode.c]
2024-12-26 feat: remove uart_bridge args
2025-01-17 feat: Start Thread packet dissector
2025-01-17 feat: Basic MLE frame
2025-01-17 feat: Wardriving thread
2025-02-06 feat: avoid leds task when leds are unsopported
2025-02-07 feat: select board configurations from sdkdefaults
    [partitions_badge.csv]
2025-02-07 feat: set Minino Board as default
2025-02-10 fix: add missing define
    [sleep_mode.c]
2025-02-10 feat: add internal partition to NO OTA partitions table
    [partitions_no_ota.csv]
2025-02-12 feat: avoid gps warning LOGs
    [gps_hw.c]
2025-02-12 fix: leds return condition
2025-02-13 fix: warbee & warthread errors on missing SD card
    [ieee_sniffer.c, sd_card.c]
2025-02-17 feat: rename partition tables & add get_builds.sh
    [partitions_4MB.csv, partitions_8MB_NO.csv]
2025-02-20 test: attempt without all boards
2025-02-21 test: use printf instead of echo
2025-02-25 feat: make all boards on new tag
2025-03-25 fix(droneid_scanner): Fix screen
    Show the nodes and reduces refresh
    [main.c, oled_screen.c]
2025-04-08 fix(catdos): Animations and bug with notification
    [oled_screen.c]
2025-04-28 feat(hw): PCB housing
    [BAT_LID-MININO.stl, PART_A-MININO.stl, PART_B-MININO.stl]
2025-05-15 feat: control mute and next track added in HID
2025-05-15 feat: control Stop, Prev Track added
    TODO: fix no scrollinf menu, fix pause function
    [ble_hidd_main.c, ble_hidd_main.h]
2025-05-27 Adds BLE scan functionality via console command
    Enables BLE device scanning using a new console command.
    This introduces a new `gattcmd_scan` command, allowing users to initiate a BLE scan directly from the console. The scan results display the addresses and RSSI of discovered devices.
    This feature is useful for identifying and connecting to nearby BLE devices.
2025-05-27 feat: Adds BLE scan functionality via console command
    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
2025-05-30 refactor: flow of the HID device items menu
2025-06-04 chore: switch back to idf 5.3
2025-06-05 chore: switch to idf v5.3.2
2025-06-19 feat: Sample app
2025-06-25 feat(gattcmd): Improves GATT command reliability and debug
    Adds debug prints for better troubleshooting.
    Fixes a potential crash when GATT registration fails.
    Cleans up GATT connection handling to prevent resource leaks.
    Removes redundant help messages from console commands.
2025-06-26 fix: back button exit in deauth scanning ap
2025-06-27 feat: add println command
2025-06-30 feat(captive): Improves captive portal functionality
    Enhances the captive portal with several improvements:
    - Adds a channel selection feature to allow users to change the Wi-Fi channel, potentially resolving connection issues.
    - Implements a captive portal detection handler to properly respond to connectivity checks from devices.
    - Modifies the Wi-Fi initialization to set the channel.
    - Improves AP scanning retry logic for a more reliable experience.
    - Prevents possible memory allocation failures.
2025-07-02 feat: Add ZB console
    [partitions.csv]
2025-07-03 feat: Integrates Zigbee CLI into main application
    Merges the Zigbee CLI functionality into the main application.
    This includes initializing and de-initializing the Zigbee console
    using dedicated commands. Also sets the prompt for the CLI.
2025-07-04 feat: Adds command to stop BLE services
    Introduces a new console command `gattcmd_stop` to halt BT scanning and connection services.
    This commit refactors common functionality for stopping BLE workers into a single function to avoid duplication.
    It also moves helper functions for address parsing and hex string conversion into a common file to improve code organization and reusability.
    [main.c]
2025-07-04 fix: Sending command from file dump
    The command reads GATT handle, address, and value from a file, and then writes the GATT value to the specified address and handle.
    It also introduces necessary dependencies and functions for file reading and GATT writing operations.
    [main.c]
2025-07-04 feat: Registers Ctrl+C handler for graceful shutdown
    Registers a Ctrl+C handler to allow the gattcmd module to
    gracefully stop its workers when a user interrupts the
    operation. This prevents resource leaks and ensures a clean
    exit.
2025-07-04 feat: Adds GATT recon command
    Implements a new GATT recon command to reconnect to a device, enumerate GATT services, characteristics, and descriptors.
    The command also handles authentication and bonding.
    It introduces a new service module for recon functionality including starting and stopping the service.
2025-07-07 chore: Zigbee CLI documentation to README
    Adds a new section to the README that documents the Zigbee CLI, including instructions for testing Zigbee connections, hardware requirements, and examples of how to use the CLI with the All Device Type example. Also includes a list of useful commands.
2025-07-08 Refactor Zigbee module with sniffer and switch
    This commit introduces the Zigbee module, enabling both a sniffer and switch functionality.
    The module includes:
    - Menu navigation for channel selection and sniffer execution.
    - Zigbee sniffer functionality for packet capture and UART transmission.
    - Zigbee switch control.
2025-07-09 feat: Adds interactive screen and ZB CLI setting
    Adds a general interactive screen component for user interaction with dynamic values and callbacks.
    This screen allows users to navigate and select values within a specified range, triggering associated callbacks. It includes visual elements like up/down arrows and dynamic text display.
    Integrates ZB CLI setting to enable or disable Zigbee CLI mode from the settings menu. Changes the default console and application flow based on the preference stored.
2025-07-09 feat: Improves SD card write and URL decoding
    Improves SD card writing reliability by using `fwrite` for writing data, and `fflush` to ensure data is written to disk.
    Also, implements URL decoding for user input in the captive portal to correctly handle encoded characters.
    [sd_card.c]
2025-07-22 refactor: wardriving wifi – store only one file per session
2025-07-24 fix: the buttons no longer open the settings menu
2025-08-01 Revert "Merge branch 'dev' into captive_merge"
    This reverts commit 480c3d709e6f2d69120626c801466e4139270320, reversing
    changes made to 1b3a158b90417fda2086d7c91837897cd655807d.
    [main.c, sd_card.c]
2025-08-01 add device name for each device to connect
2025-08-01 feat: Add mac address filter for BLE recon app
2025-08-05 feat: Add version to minino & add filter file to captive
2025-09-23 feat: Add delete button to file manager web
2025-10-01 feat: Add config options
    - AGNSS
    - Power mode
    - Advanced
2025-10-02 feat: Add update rate
    1 Hz
    5 Hz
    10 Hz
2025-10-22 test(fw): isolate zigbee, thread and ieee8011.145
    [partitions_8MB_NO.csv]
2025-10-22 fix: set functions as the prototype
2025-10-22 fix: set parameters for some functions
    [ledc_controller.c]
2025-10-23 fix(fw): set prototypes for functions in general selections
2025-10-23 fix(fw): define variable with prototype
2025-10-23 feat(fw): remove thread and zigbee modules and apps
2025-10-23 feat: add task manager, error handler and memory monitor
    [main.c]
2025-10-23 feat: add task manager led events
2025-10-24 fix: improve concurrency safety and memory handling
    [uart_sender.c]
2025-11-25 feat: add files for uart-bridge app
2025-12-09 feat: add usb-uart bridge
2025-12-17 refactor(fw): add zigbee and thread menus again
2025-12-17 refactor(fw): move zigbee and thread files
2025-12-18 fix(fw): add parameters on cmd callbacks functions
    [ieee_sniffer.c]
2025-12-19 refactor(fw): put zigbee and thread modules again
    At this commit the code is not compiling
2025-12-19 fix(fw): change partameter for prototype
    [ieee_sniffer.c, ieee_sniffer.h]
2025-12-26 feat(fw): minino compiles with zigbee and thread
2026-04-17 feat: Updated print statements to use console output functions for better formatting and consistency. - Enhanced user feedback during CSV loading, data cleaning, and analysis processes. - Improved vi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
2026-04-17 feat: improve error handling in WardrivingAnalyzer by using print_error for exceptions
2026-04-20 fix: simplify header label in print_header function
2026-04-28 fix(zigbee): ensure proper task deletion during Zigbee switch deinitialization and update display status conditionally
2026-04-29 fix(zigbee): add delay and restart in deinitialization for Zigbee light and switch components
2026-04-29 feat(zigbee_light): integrate LED control for light state changes and enhance visual feedback during network operations
2026-04-29 feat(thread_sniffer): enhance packet handling and logging in thread sniffer module
2026-04-29 feat(thread_sniffer): add channel management and event handling for packet sniffer
2026-04-29 feat(thread_sniffer): set channel after enabling promiscuous mode and improve log message
2026-04-29 feat(thread_sniffer): improve task handling and event logging in thread sniffer
2026-04-30 fix(thread_sniffer): improve memory allocation handling in pcap_start function
2026-04-30 fix: improve task handle management across multiple modules
    [buzzer.c]
2026-04-30 fix(animations_module, oled_screen): add error handling for mutex creation
    [oled_screen.c]
2026-05-04 fix(thread_broadcast): add error handling for UDP message reception fix(trackers_scanner): improve task deletion and state management fix(wifi_ap_manager): enhance connection handling and preferences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
2026-05-04 fix(buzzer): add task handle cleanup in buzzer_play_for function
    [buzzer.c]
2026-05-04 Refactor and clean up code across multiple modules
    - Removed unused function declarations and variables in http_server, bt_gatts, bt_spam, buzzer, id_open, id_open_esp32, odrone_id, spoofer, flash_fs, ieee_sniffer, ledc_controller, nmea_parser, sd_card, thread_broadcast, uart_sender, zigbee_light, and various command modules.
    - Updated logging macros to use consistent naming conventions in bt_gatts.
    - Fixed type casting issues for string parameters in various modules to ensure proper handling of character pointers.
    - Improved memory management by ensuring proper allocation and deallocation of dynamic memory in menus_module and gps modules.
    - Enhanced readability by adding const qualifiers wh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
    [buzzer.c]
2026-05-04 refactor(auth): remove unused variable and simplify authentication data handling refactor(wifi): initialize wifi_config_t with empty braces for clarity fix(esp32): suppress missing-field-initializers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
2026-08-21 refactor(drivers): optimize preferences handling, buzzer control and storage components
    [buzzer.c, buzzer.h, oled_driver.c, sd_card.c]
2026-08-21 refactor(thread): update OpenThread broadcast and WarBee/WarThread modules
2026-08-21 refactor(ui): update menus, keyboard modals, animations and power saving modules
2026-08-23 docs(surveillance): add design spec for the surveillance detector
    Synthesises the detection engines of flock-you (MIT) and eye-spy
    (Apache-2.0) into a native ESP-IDF component for Minino: confidence
    tiers with the Flock IE fingerprint, eye-spy's accumulating score,
    signature overlay from microSD, GPS-tagged CSV/GPX logging and pcap
    evidence.
2026-08-23 docs(surveillance): switch host tests to gcc + vendored Unity
    The ESP-IDF linux target needs libbsd-dev, which is not installed and
    needs sudo. Host tests now build with plain gcc against the Unity
    sources vendored in ESP-IDF. A TEST_CASE shim with constructor-based
    auto-registration keeps the test files identical to the ESP-IDF style,
    so only Task 1 changes. CI drops the toolchain install entirely.
2026-08-23 feat(surveillance): add component skeleton, signature tables and host tests
    Task 1 of the surveillance_detect component: shared types, the base OUI
    signature table (75 entries transcribed from eye-spy's es_detect.h across
    Flock, Flock-MFR, SoundThinking, ALPR, CAM plus the Axon BLE OUI), a
    gcc/Unity host test harness independent of idf.py, and no-op stubs for the
    radio/public-API files so idf.py build passes for esp32c6. Tasks 2-10 fill
    in matchers, engine, radio and UI.
    Claude-Session: https://claude.ai/code/session_01EovhzYZFPG6Ed5BE8DYwYx
2026-08-23 docs(surveillance): pin Task 9 API shapes in Task 1 stubs and add provenance
2026-08-23 fix(surveillance): align stub API with Task 9 and add surv_types.h provenance
    Review findings from Task 1 (both plan defects, not implementation errors):
    - surv_profile_t now describes what is being hunted (FLOCK/SURVEIL/TRACKERS)
    instead of which radio is on, matching Task 9's declared API; the callback
    is renamed surv_detect_cb_t and now carries the match score. surv_radio.h
    picks up surv_profile_t from surveillance_detect.h instead of redefining
    it, since Task 9 owns the concept.
    - surv_types.h gets the provenance notice its surv_class_t taxonomy and
    SURV_TIER_* levels were missing (eye-spy es_confidence.h DECL_DETECTOR
    set, Apache-2.0; flock-you, MIT), matching surv_signatur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
    [surv_radio.h, surv_types.h, surveillance_detect.c, surveillance_detect.h]
2026-08-23 feat(surveillance): add case-insensitive SSID keyword matcher
    Implement surv_match_contains_ci() for case-insensitive substring search and
    surv_match_ssid() for SSID keyword matching. Add 43-entry keyword table ordered
    from most specific to least specific (flocksafety before flock before cam).
    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
2026-08-23 docs(surveillance): drop motorola and lpr from base ALPR keywords
    They break the zero-false-positive acceptance criterion for the ALPR
    class: motorola matches the default SSID of consumer Motorola/Arris
    modems, which Izzi and Totalplay ship by the million in Mexico, and lpr
    matches inside HelpRouter and HP_LPR_* printers. Both can be restored
    via the microSD overlay.
2026-08-23 fix(surveillance): remove motorola and lpr keywords that break zero false-positive criterion
    "motorola" matches default SSID of Motorola/Arris modems shipped by Izzi and
    Totalplay in Mexico. "lpr" matches HelpRouter and HP_LPR_* printers. Both break
    the zero false-positive ALPR acceptance criterion. Add regression tests to
    prevent reintroduction.
    Keyword table reduced from 38 to 36 entries.
    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
    [surv_signatures.c]
2026-08-23 feat(surveillance): add shared BLE advertising dissector
    Add surv_match_ble_adv(), the single TLV parser for BLE advertisements
    shared across the surveillance detector, plus the UUID/BLE-name/skimmer
    signature tables it consumes (eye-spy, Apache-2.0). Unlike
    trackers_scanner's first-match break, this returns up to
    SURV_BLE_MAX_HITS distinct classes per advertisement since a single
    device can be e.g. both iBeacon and AirTag.
    Corrected two byte literals in the AirTag/iBeacon host tests (declared
    TLV length must match the truncated test buffer, matching the pattern
    already used by every other TLV test in this file) so they exercise
    the intended match path instead of tripping the truncated-adve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
    [surv_match.c, surv_match.h, surv_signatures.c]
2026-08-23 feat(surveillance): add binary IE fingerprint matcher for Flock probes
2026-08-23 fix(surveillance): remove dead FCS retry, correct claimed test coverage
    The FCS retry in surv_ie_matches_flock() was provably unreachable: the
    tokens_match_sig() walk exits as soon as it completes the signature
    (t == sig_len), and its only length-sensitive guard only gets stricter
    as the buffer shrinks, so a failed primary pass can never succeed on
    retry. Removed it in favor of relying on the walk's early exit, which
    already tolerates trailing bytes (FCS included) by construction.
    Adds a test for the previously-untested SURV_IE_MAX_TOKS guard in
    surv_ie_add_signature().
    [surv_ie.c]
2026-08-23 feat(surveillance): add microSD signature overlay parser
    Parses text already in memory (never a path, keeping it host-testable)
    into OUI/keyword/UUID additions and removals plus extra IE signatures,
    then rebuilds the effective tables in surv_signatures.c so surv_match_init()
    picks them up. Malformed lines are counted and skipped, never crash or
    partially apply; caps (256 OUIs, 64 keywords, 16 UUIDs, 8 IE sigs) bound
    a hostile or corrupt overlay file.
    Fixes two bugs found in the process: the effective-OUI array was sized
    off a stale base-table count that would have overflowed by one element
    at the 256-overlay cap, and parse_ie_token() accepted a bare tag-221
    token with no vendor payload, whi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
    [surv_overlay.c, surv_overlay.h, surv_signatures.c]
2026-08-24 fix(surveillance): reject IE tag 0 and truncated overlay signatures, unify overlay caps
    Review of the overlay parser found two more silent-failure traps of the
    same shape as the 221-without-payload case already fixed, plus one
    unsynchronized-constants risk of the same shape as the stale base-table
    size already fixed:
    - parse_ie_token() used atoi(), which returns 0 both for an explicit "0"
    and for garbage like "xyz". tokens_match_sig() treats IE tag 0 as the
    SSID element and skips it before ever comparing it against the
    signature, so a tag-0 token can never let a signature complete: it
    loads as "added" but can never match, and burns one of only 8 overlay
    signature slots. Switched t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
    [surv_overlay.c, surv_signatures.c, surv_signatures.h]
2026-08-24 feat(surveillance): add lock-free queue, sniffer callback and public API
    Wires the WiFi promiscuous callback to the OUI/IE matchers, hands hits
    across a lock-free ring buffer to the surv_engine task, and implements
    the surv_begin/surv_stop/surv_register_cb/surv_queue_overflows API.
    The callback only compares and enqueues (no logging, allocation, or
    blocking); surv_begin() calls surv_match_init() before anything else
    so surv_match_oui() never silently returns NULL. Also adds
    RADIO_SELECT_SURVEILLANCE and radio_selector_set_surveillance().
    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
2026-08-24 docs(surveillance): gate on rx_state and factor the tier clamp
2026-08-24 fix(surveillance): reject error-flagged frames, factor tier clamp
    The promiscuous callback did not check rx_ctrl.rx_state, so a frame the
    hardware flagged as received-in-error could carry a corrupted addr1/
    addr2 that collides by chance with a known OUI prefix and feeds the
    OUI-only tier-1/tier-2 paths -- the noisiest ones -- with garbage. The
    project's acceptance criterion is zero false positives of class
    FLOCK/ALPR, so this guard is added alongside the existing RSSI and
    length checks.
    Also factors the three differently-written tier-ceiling clamps into a
    single clamp_tier() helper (an inverted ternary in only one of the
    three would have silently promoted a contract-manufacturer OUI to a
    co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
    [surveillance_detect.c]
2026-08-24 fix(surveillance): restore the IE fingerprint field patches and add a differential test
    The binary IE matcher was strictly stricter than the flock-you algorithm it
    reimplements: measured against the original over 25k inputs it disagreed on
    3020, every one of them a camera the reference confirms and we did not. The
    spec and the plan both promised the three field patches in prose while the
    plan's own code sample implemented none of them, so no reviewer had anything
    to check the promise against.
    Restored: phantom-overflow skipping, TLV resync, and LiteON-anchored
    canonicalisation. Vendor tokens now carry up to 8 bytes with a significant
    vlen, matching the reference's min(elen, 8) — two IEs s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
    [surv_ie.c, surv_ie.h]
2026-08-24 refactor(trackers): use shared BLE dissector and passive scanning
    trackers_scanner now delegates advertisement parsing to
    surv_match_ble_adv() instead of keeping its own copy of the AirTag/
    SmartTag/Tile TLV parser, so BLE advertising is parsed in one place.
    tracker_dissector() filters the shared dissector's hits down to the
    four tracker classes this app shows (AirTag, SmartTag, Tile, Apple
    Nearby) and ignores the rest (Flock, Axon, drones, etc.), which belong
    to the surveillance_detect app.
    bt_gattc gains bt_gattc_set_passive_scan(), a one-shot opt-in consumed
    by the very next bt_gattc_set_default_ble_scan_params() call so it
    never lingers as the default for other bt_gattc consumers (ble_s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
2026-08-24 fix(surveillance_detect): sweep deferred minor findings
    Batch fix for six deferred Minor findings from task review in
    surveillance_detect:
    - Add missing SPDX-License-Identifier header to CMakeLists.txt and
    .github/workflows/host-tests.yml.
    - parse_oui() now requires the overlay OUI field to be exactly "xx:xx:xx"
    (length check plus sscanf %n) instead of accepting trailing garbage,
    including a full 6-octet MAC where an OUI was meant.
    - Overlay points/tier fields for +oui, +ssid/+blename and +uuid now go
    through a strtol-based parse_u8_field() (same pattern as the existing
    parse_ie_token) instead of atoi, so a non-numeric field is rejected
    (counted as skipped) instead of silently l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
    [surv_engine.c, surv_match.c, surv_overlay.c]
2026-08-24 fix(surveillance_detect): make decay-anchor flag consistent across all writers
    Review of the finding-6 sentinel-to-flag refactor found it incomplete:
    surv_engine_tick()'s score==0 branch still wrote s_last_decay_ms
    unconditionally but never set the new s_decay_anchor_set flag, only
    surv_engine_submit() did. In production the engine task calls tick() every
    ~100 ms including before the first-ever detection, so under the old
    ms==0 sentinel those pre-detection ticks already moved the anchor away from
    the "unset" value; under the new flag they didn't, so the first submit()
    call would overwrite the tick-established anchor with its own now_ms,
    shifting the next decay by about one tick period.
    Fix: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
    [surv_engine.c]
2026-08-25 feat(surveillance): enhance detection engine with scoring, radio sniffer and overlay parser
    - Add lock-free queue for sniffer callback
    - Reject IE tag 0 and truncated overlay signatures
    - Factor tier clamp and gate on rx_state
    - Define score thresholds once instead of duplicating literals
    - Reject error-flagged frames in scoring engine
    - Add microSD signature overlay parser
    - Improve vendor token rejection and payload validation
    [surv_engine.h, surv_match.c, surv_match.h, surv_overlay.c, surv_radio.c, surv_radio.h, surv_signatures.c, surv_types.h]
2026-08-25 refactor(wifi): improve wifi controller, attacks, AP manager and sniffer
    - Add wifi_ap_config.h for AP configuration
    - Improve wifi_controller state management
    - Enhance wifi_attacks with better deauth handling
    - Update captive portal, deauth and SSID spam modules
    - Improve dns_server and buzzer components
    - Refactor leds and ledc_controller
    [buzzer.c, ledc_controller.c, leds.c]
2026-08-25 feat(core): improve task manager, file manager, settings and UI
    - Refactor task_manager with improved state handling
    - Enhance file_manager with better directory navigation
    - Update OLED driver with improved rendering
    - Improve general_screens and flash storage
    - Add menus.h with 100+ new menu entries
    - Refactor keyboard modal and animations module
    - Update settings, GPS, zigbee, war_bee and war_thread modules
2026-08-25 chore: update build config, dependencies and Dockerfile
    - Rename dockerfile to Dockerfile (convention)
    - Add partitions_no_ota.csv for no-OTA partition scheme
    - Add console idf_component.yml dependency
    - Update main CMakeLists.txt with new source files
    - Update idf_component.yml dependencies
    - Update GitHub Actions build workflow
    [partitions_no_ota.csv]
2026-08-27 fix(surveillance): prevent display freeze and esp_restart loop on back exit
    [main.c, surv_radio.c]
2026-08-27 fix(trackers): optimize tracker scanner stop mutex and slim wifi buffers
    [surv_ie.c, surv_ie.h, surv_radio.h, surv_types.h, surveillance_detect.c, surveillance_detect.h]
2026-08-27 fix(bt_spam): robust GAP sync, error recovery, power fallback and thread-safe UI
2026-08-31 feat(ble): add power profiles, heap stats and GAP dispatcher
2026-08-31 feat(trackers): redesign UI with RSSI meter and GPS coordinates
    [surv_ie.c, surv_radio.c, surveillance_detect.c, surveillance_log.c]
2026-08-31 fix(wifi): resolve memory leaks in ssid_spam and protocol cleanups
    [buzzer.c]
2026-08-31 fix(surveillance): prevent duplicate headers and require triangulated GPS for logging
    [surveillance_log.c]
2026-09-01 fix(ci): increase factory partition size to 3400K in partitions_4MB.csv
    The bsseattle binary (0x316150 bytes) overflowed the 3M factory
    partition by ~90KB. Increases it to 3400K, leaving ~239KB headroom
    above the current binary size and ~102KB of unused flash below the
    4MB physical limit. This partition table is shared by bsides,
    dragonjar, ekoparty, bugcon, and bsseattle.
    [partitions_4MB.csv]
2026-10-11 feat: Add selectable OLED menu view styles
    Add a menu-view framework that renders the menu in a user-selected style,
    chosen from Settings and persisted across reboots. Classic stays the default
    and is unchanged, so nothing regresses. New styles: Icon List, Grid, and
    Hero + Dock, built on a shared drawing and icon toolkit.
    - menu_views: view registry and render-only dispatch via menu_views_render,
    driven by the "menu_view" preference
    - menu_gfx: pixel-placed and scaled text, outline frame, scrollbar helpers
    - menu_icons: 12x12 icon library and item-name to glyph mapping
    - menu_style: Settings > Menu Style radio picker
    - menus_module: route display_menus through the active view
2026-10-26 feat(rf_spectrum): add 2X peak tracker, smart anti-jammer and EMA filters
